wig-nesh/4-bit-cla-adder/report/images/nor_cmos_post_tran-eps-converted-to.pdf

tran1: 2023102019

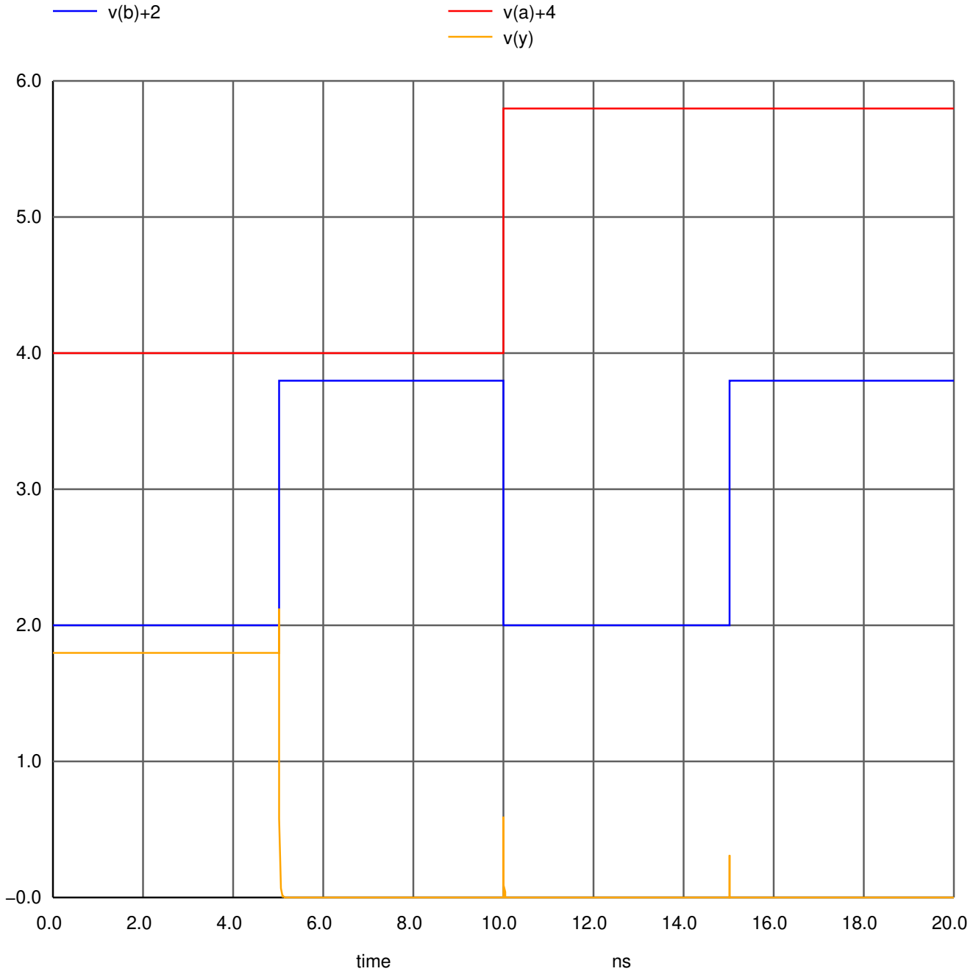
[picture p34: figure]
time
