wig-nesh/4-bit-cla-adder/report/images/xor_cmos_tran-eps-converted-to.pdf

tran1: 2023102019
v(b)+2 | v(a)+4
| v(y)

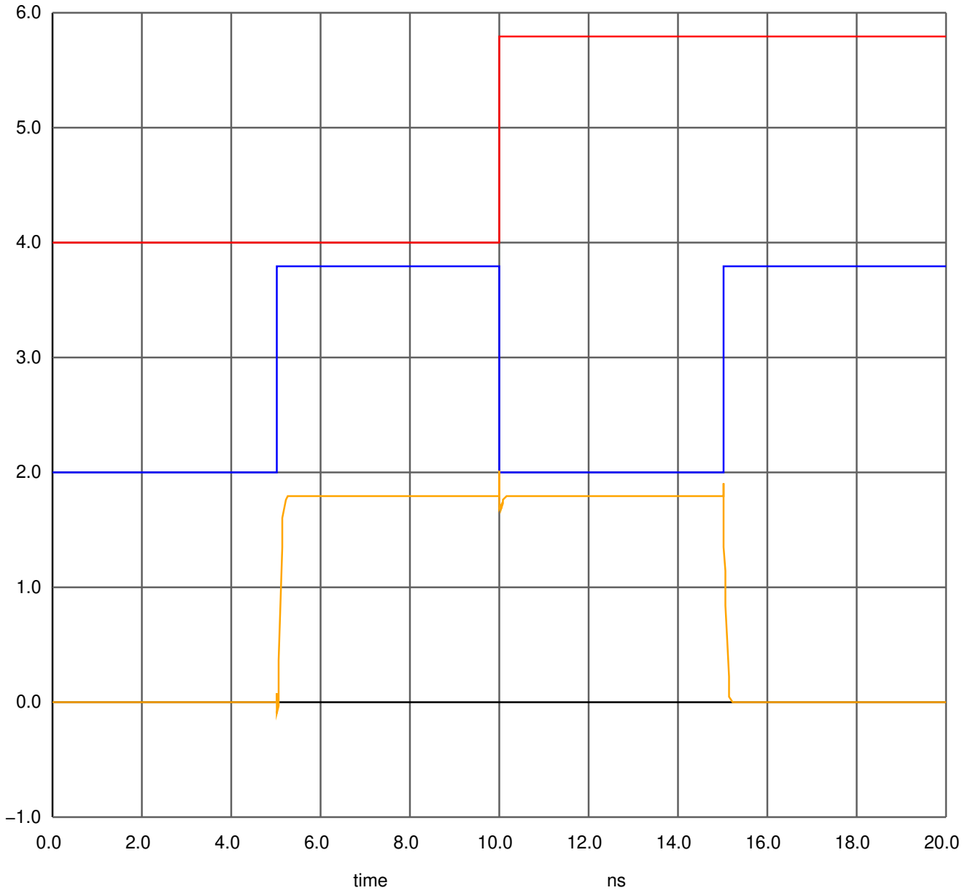
[picture p37: figure]
time
