wig-nesh/4-bit-cla-adder/verilog_fpga_simulation/full/output.pdf

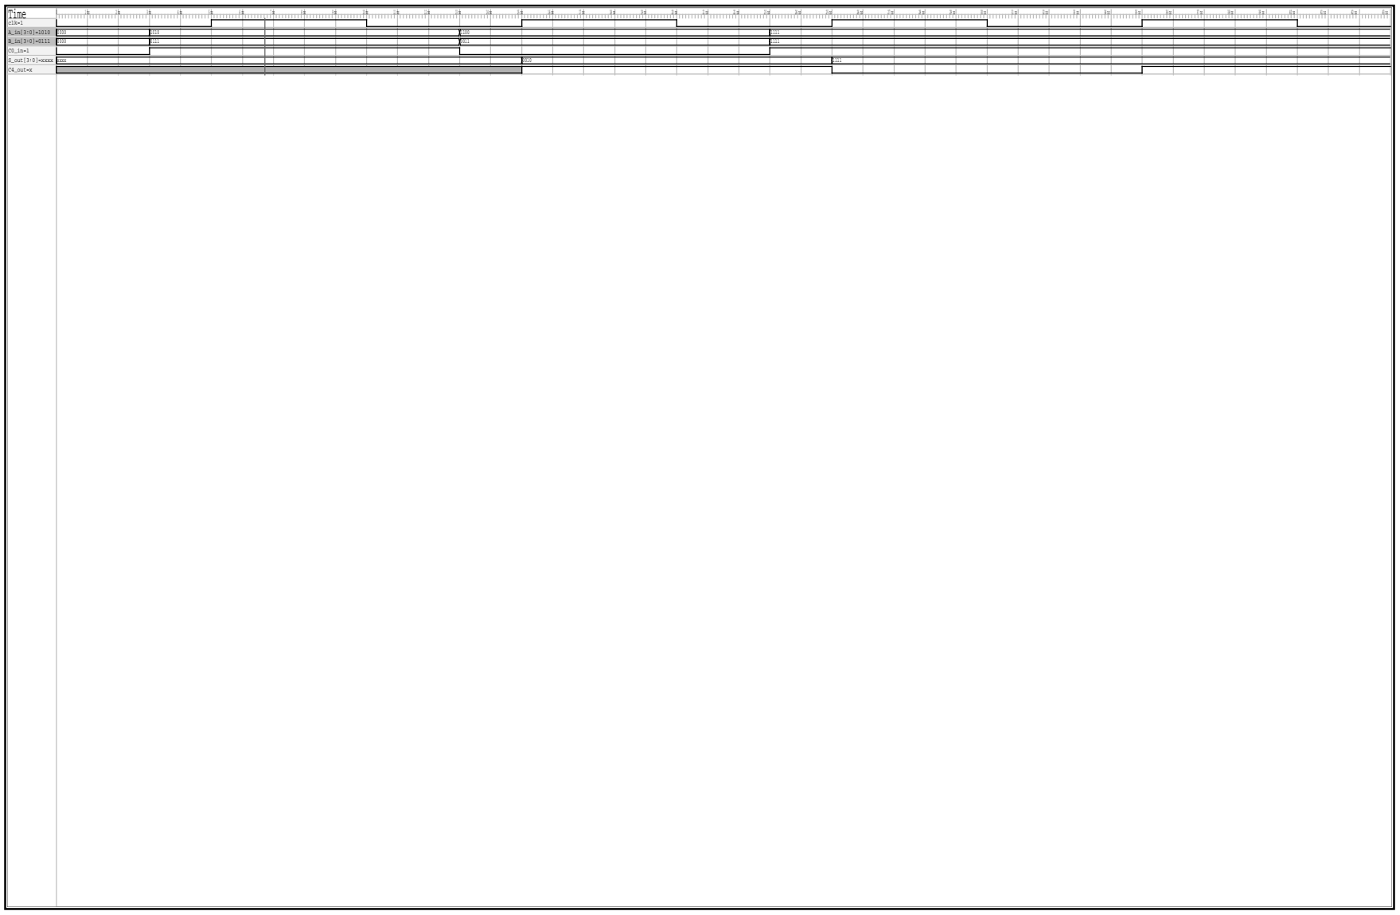
[picture p39: figure]
xxxx; Time; clk=1 A_in[3:0]=1010 B_in[3:0]=0111 C0_in=1 S_out[3:0]=xxxx C4_out=x
