wig-nesh/4-bit-cla-adder/verilog_fpga_simulation/blocks/4_bit_cla/output.pdf

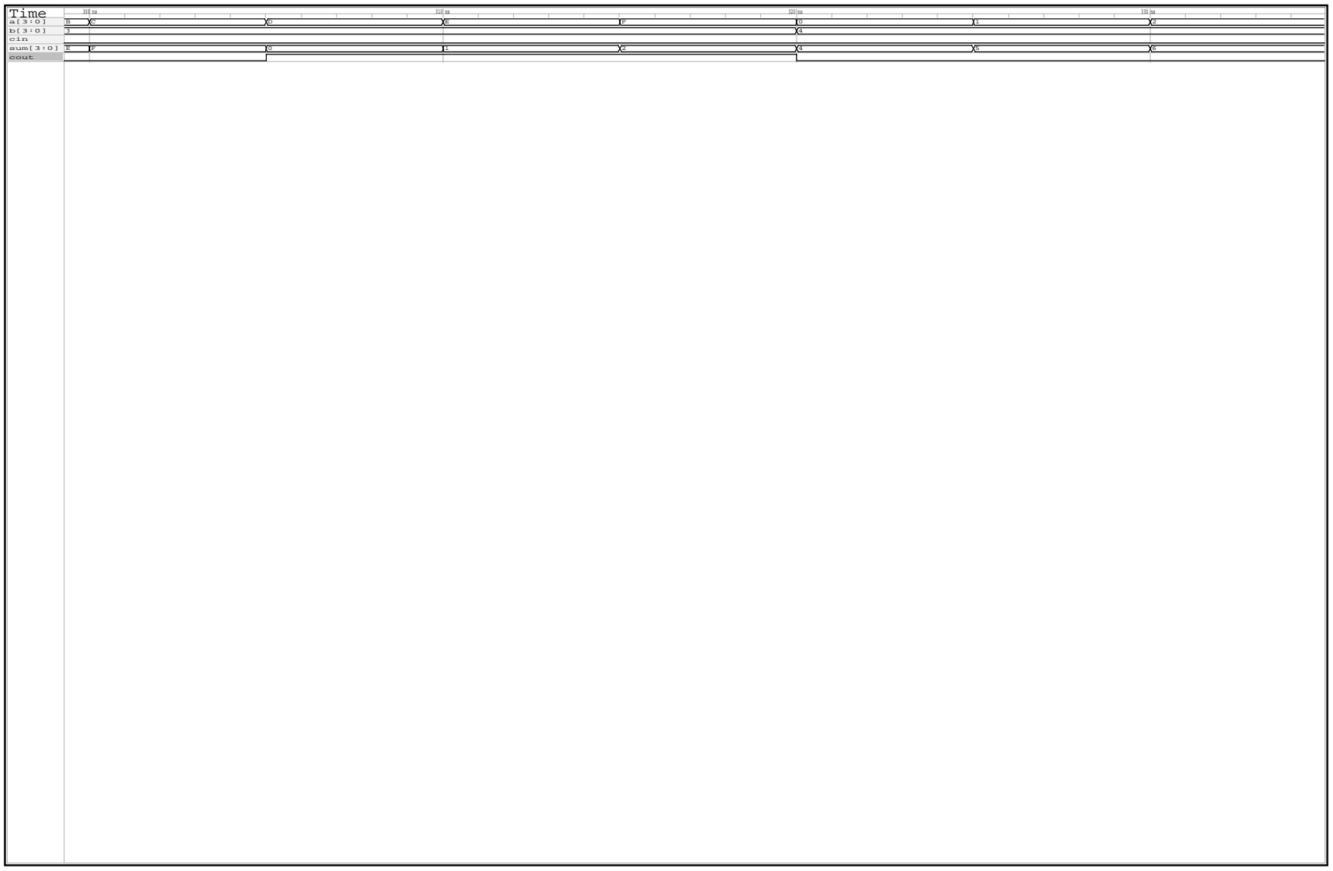
[picture p40: figure]
Time; a[3:0] b[3:0] cin sum[3:0] cout
