wig-nesh/4-bit-cla-adder/report/report.pdf

# 4-bit CLA Adder VLSI Course Project

1

# st Vignesh Vembar

# ECE, IIIT Hyderabad

2023102019

# vigneshvembar.m@students.iiit.ac.in

# Abstract—This document is a report on the Design and

Simulation of a 4-bit Carry Look Ahead Adder.

# I. INTRODUCTION

# The Carry Look Ahead Adder is a digital circuit that is used to add two 4 bit binary numbers. It is faster than the Ripple Carry Adder as it generates the carry signals for all the bits

at the same time.

# II. PROPOSED DESIGN

# A. CLA Adder

# B. D Flip Flop

# III. VERILOG SIMULATION

# A. CLA Adder

# Fig. 1: GTKWave Plot of CLA Adder Verilog Simulation

# B. D Flip Flop

# Fig. 2: GTKWave Plot of D Flip Flop Verilog Simulation

# C. Full Circuit

# IV. NGSPICE SIMULATION

# A. Inverter

time

tran1: 2023102019

0.0 | 2.0 | 4.0 | 6.0 | 8.0 | 10.0 | 12.0 | 14.0 | 16.0 | 18.0 | 20.0

ns

−0.5

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
v(y) | v(a)+2

# Fig. 3: NGSPICE Plot of Inverter

# B. NAND Gate D. XOR Gate

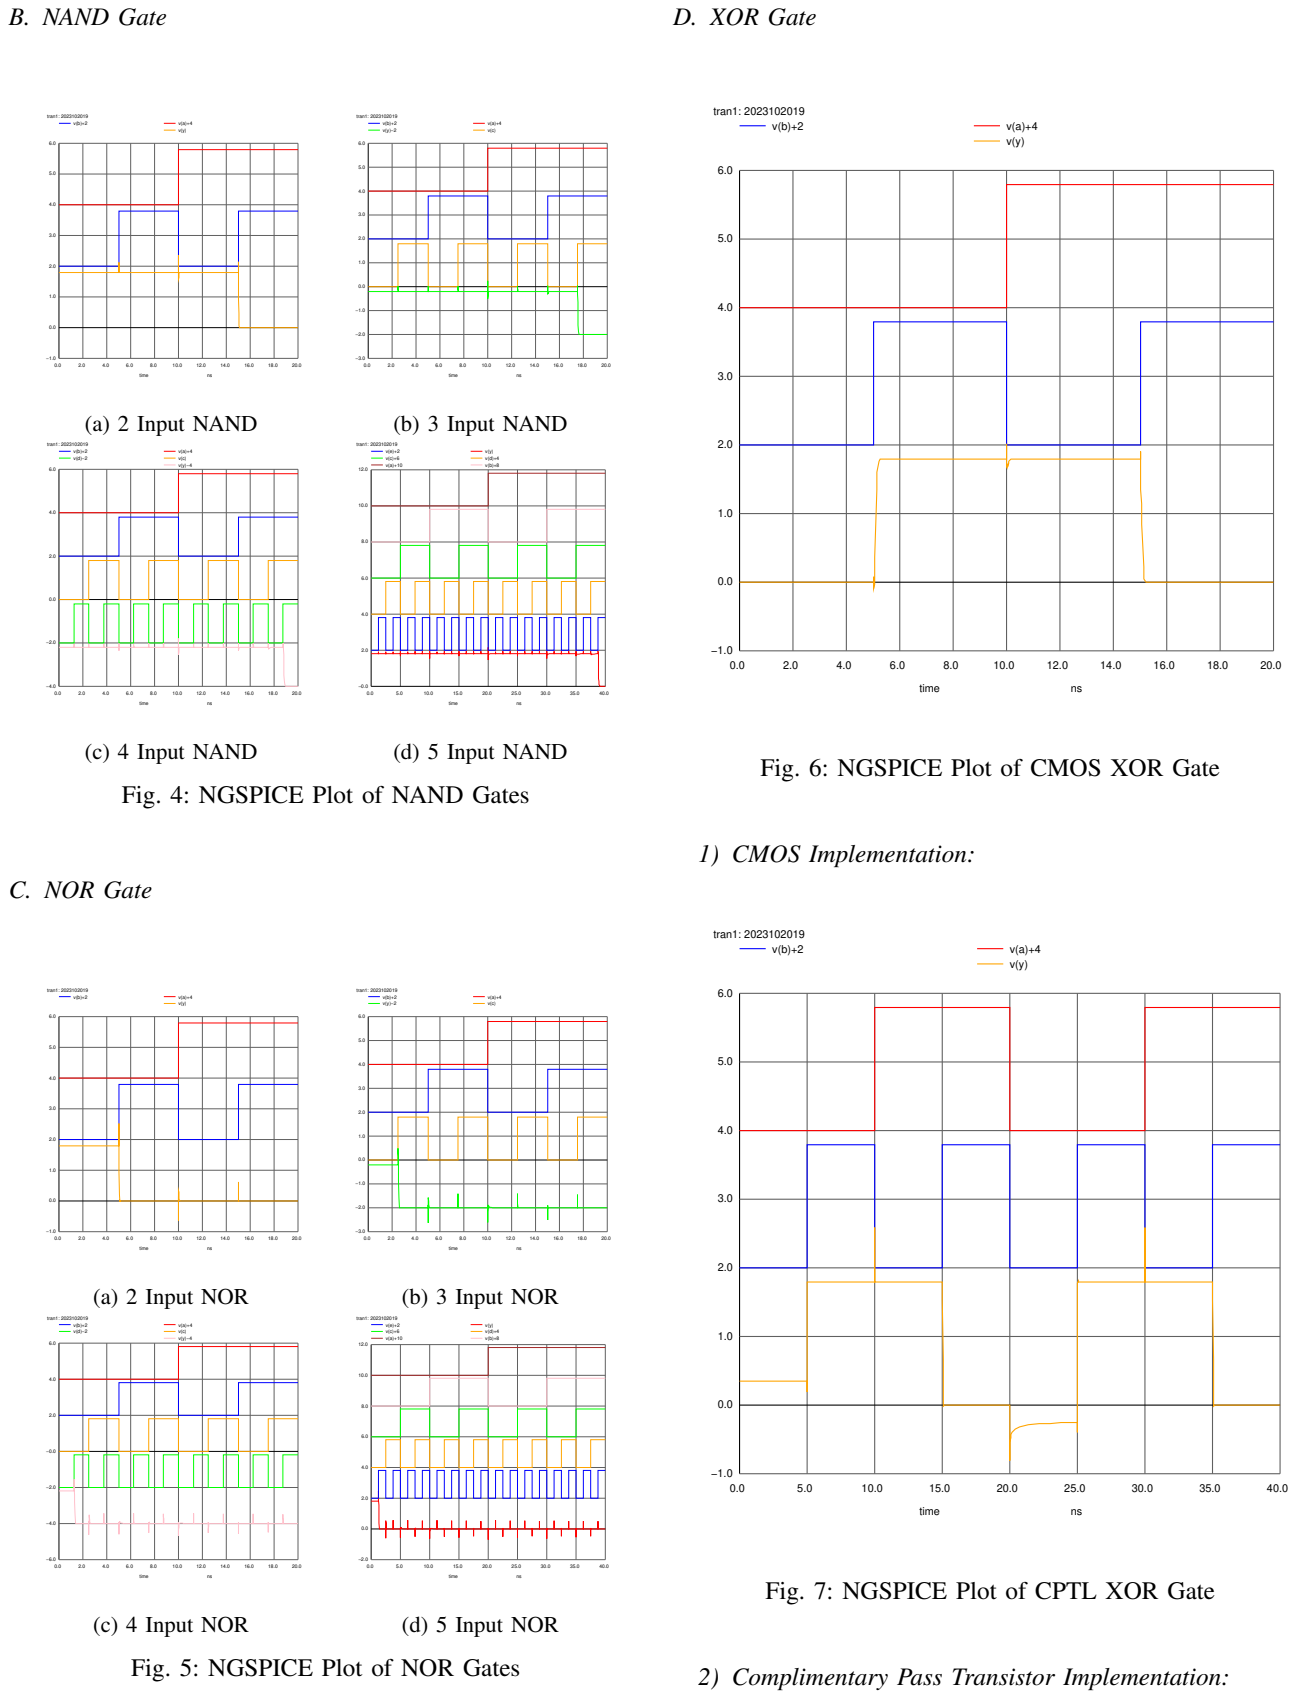
[picture p41: page 2]
time; tran1: 2023102019; (a) 2 Input NAND; (b) 3 Input NAND; (d) 5 Input NAND; C. NOR Gate; (a) 2 Input NOR; (b) 3 Input NOR; (d) 5 Input NOR; 1) CMOS Implementation:

(c) 4 Input NAND
Fig. 4: NGSPICE Plot of NAND Gates

Fig. 6: NGSPICE Plot of CMOS XOR Gate

Fig. 7: NGSPICE Plot of CPTL XOR Gate

(c) 4 Input NOR
Fig. 5: NGSPICE Plot of NOR Gates

2) Complimentary Pass Transistor Implementation:

# E. Propagate/Generate Generator

# F. Carry Look Ahead Generator

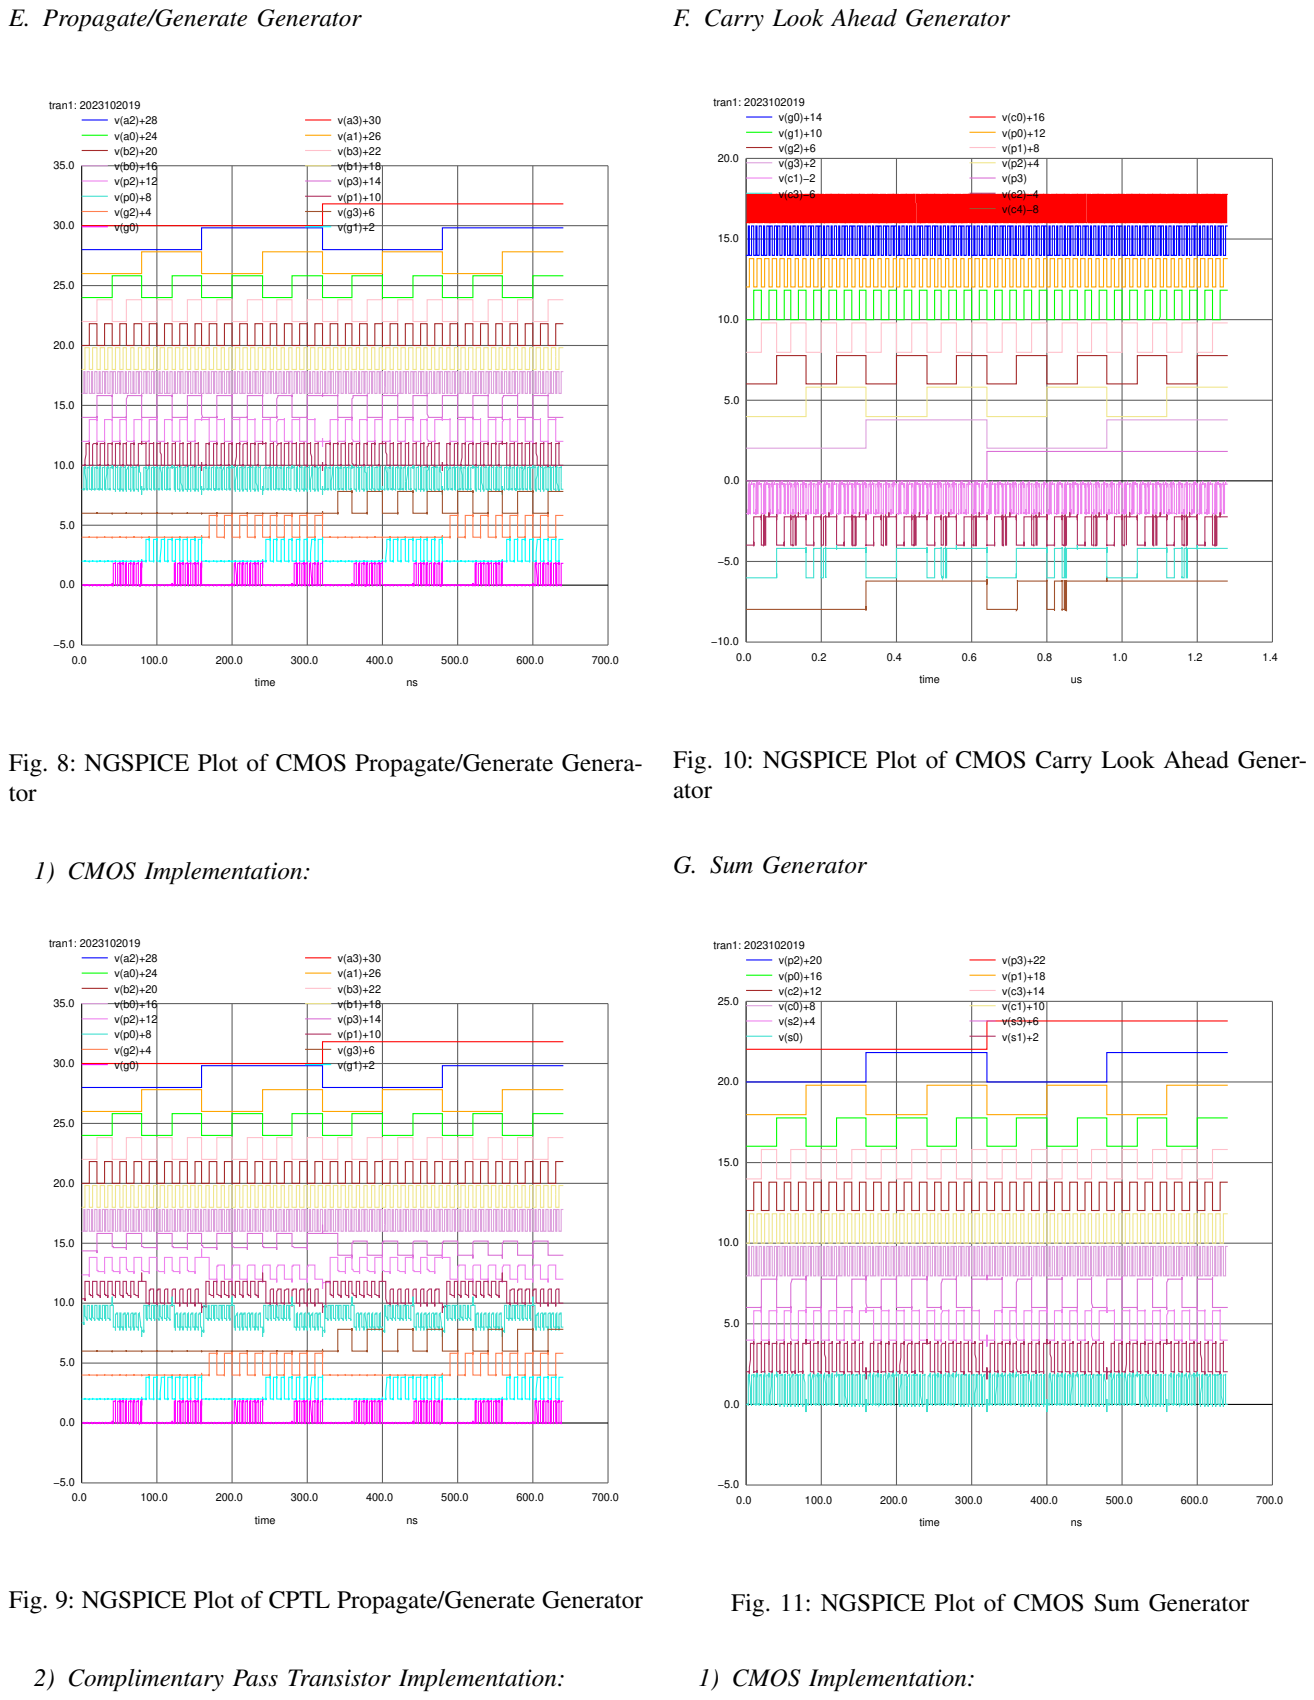
[picture p42: page 3]
time; tran1: 2023102019; 1) CMOS Implementation:; G. Sum Generator

Fig. 8: NGSPICE Plot of CMOS Propagate/Generate Genera-
tor

Fig. 10: NGSPICE Plot of CMOS Carry Look Ahead Gener-
ator

Fig. 9: NGSPICE Plot of CPTL Propagate/Generate Generator

Fig. 11: NGSPICE Plot of CMOS Sum Generator

2) Complimentary Pass Transistor Implementation:

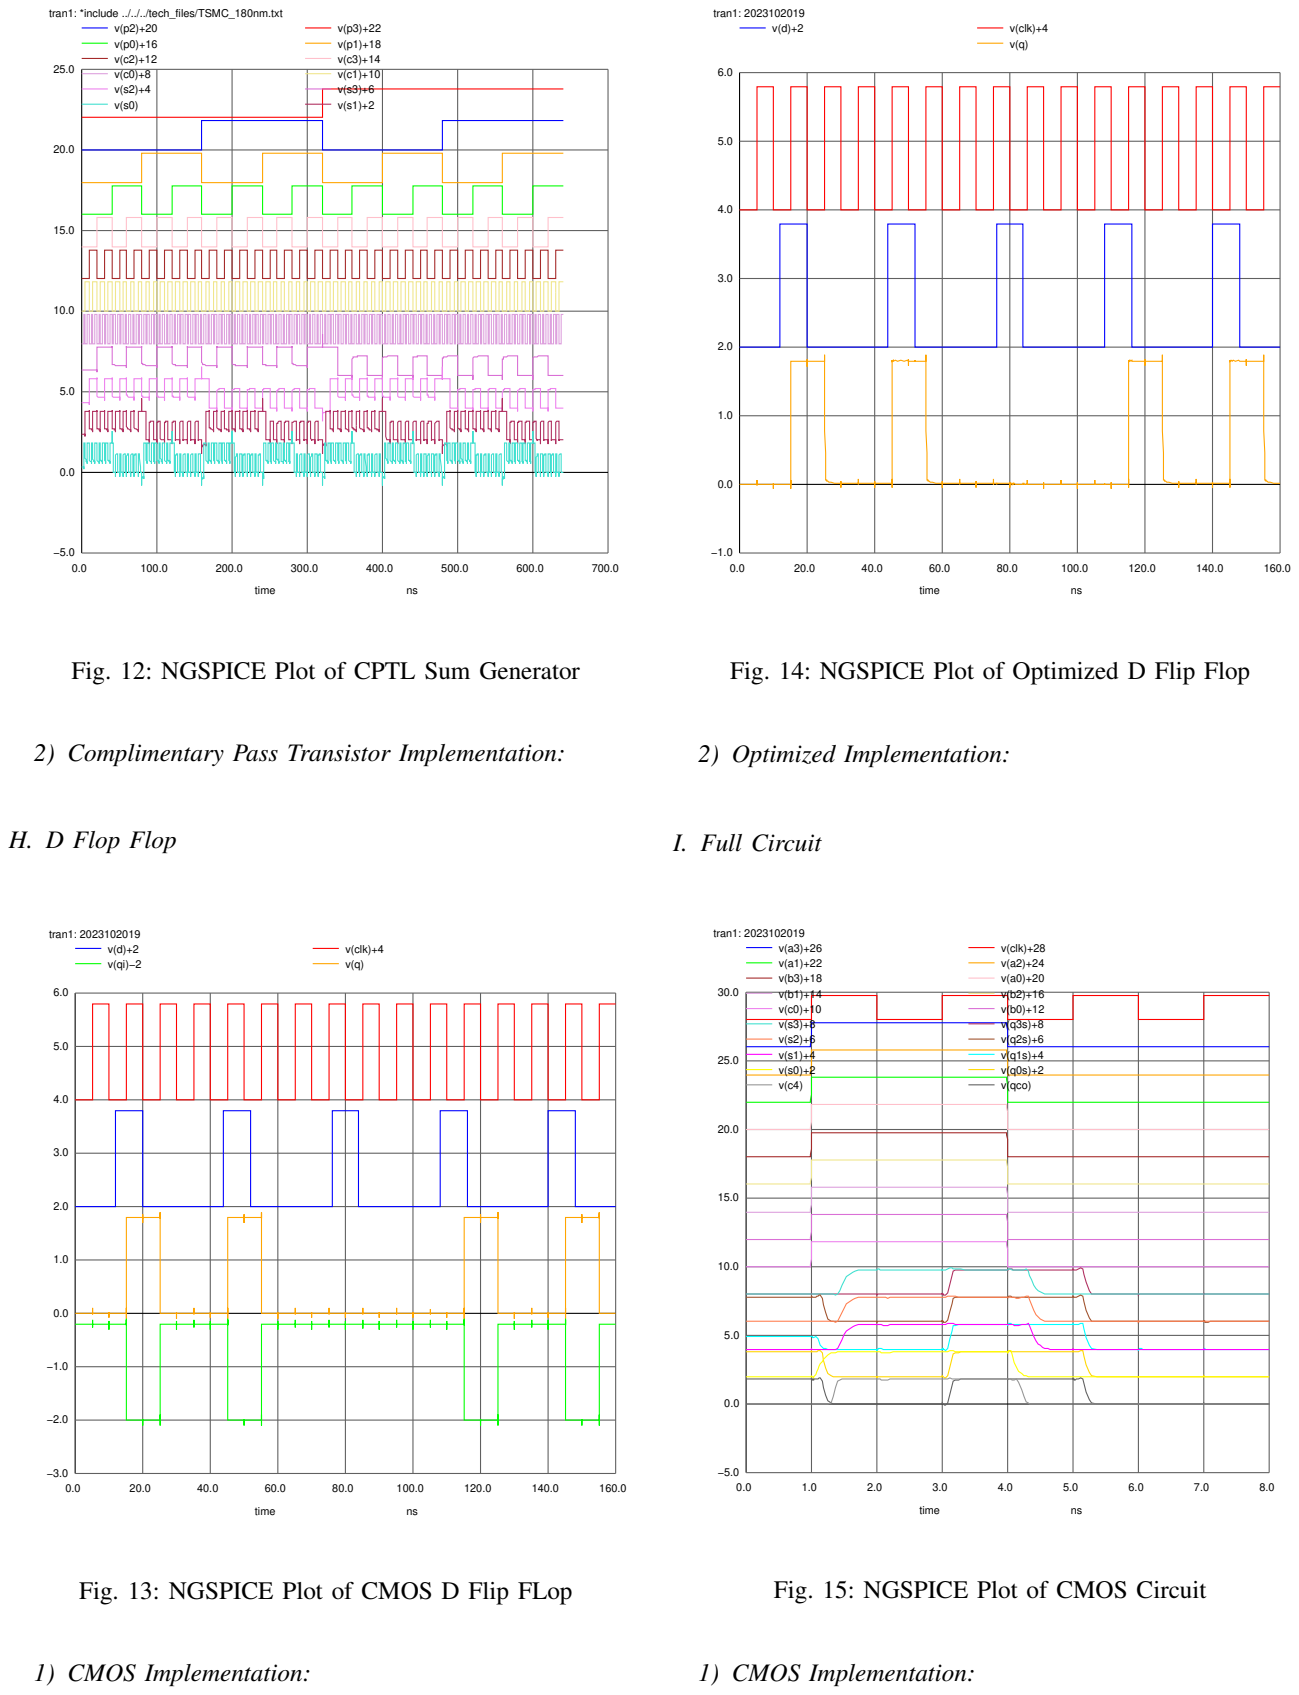
[picture p43: page 4]
time; tran1: *include ../../../tech_files/TSMC_180nm.txt; H. D Flop Flop; tran1: 2023102019; v(clk)+4; 1) CMOS Implementation:; 2) Optimized Implementation:; I. Full Circuit; v(clk)+28; v(qco)

Fig. 12: NGSPICE Plot of CPTL Sum Generator

Fig. 14: NGSPICE Plot of Optimized D Flip Flop

2) Complimentary Pass Transistor Implementation:

Fig. 13: NGSPICE Plot of CMOS D Flip FLop

Fig. 15: NGSPICE Plot of CMOS Circuit

# B. NAND Gate

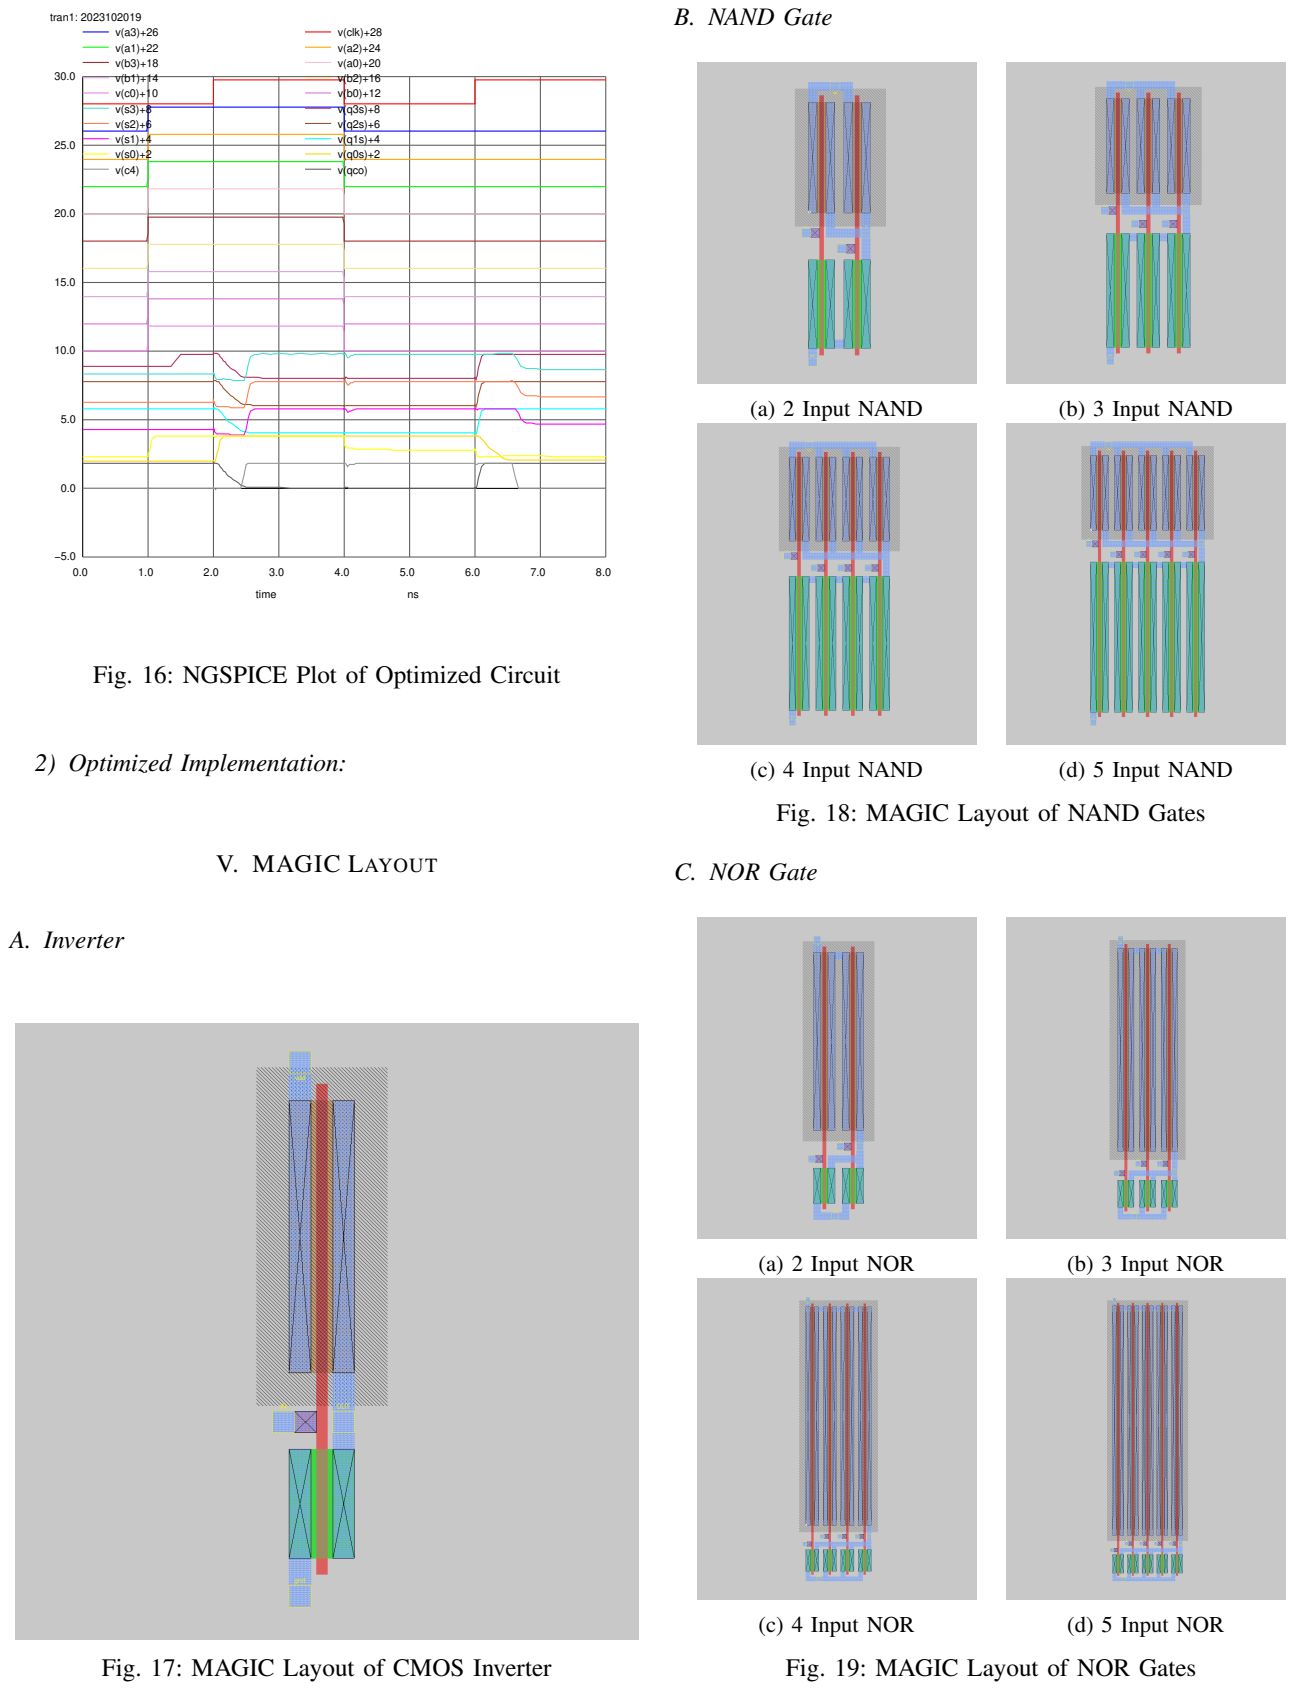
[picture p44: page 5]
time; tran1: 2023102019; v(clk)+28; 2) Optimized Implementation:; V. MAGIC LAYOUT; A. Inverter; (a) 2 Input NAND; (b) 3 Input NAND; (c) 4 Input NAND; (d) 5 Input NAND; C. NOR Gate; (a) 2 Input NOR; (b) 3 Input NOR; (c) 4 Input NOR; (d) 5 Input NOR

v(s0)+2 v(c4) | v(q0s)+2 v(qco)

Fig. 16: NGSPICE Plot of Optimized Circuit

Fig. 18: MAGIC Layout of NAND Gates

Fig. 19: MAGIC Layout of NOR Gates

Fig. 17: MAGIC Layout of CMOS Inverter

# D. XOR Gate

# E. Propagate/Generate Generator

# F. Carry Look Ahead Generator

# G. Sum Generator

# H. D Flop Flop

# I. Full Circuit

# VI. POST LAYOUT SIMULATION

# A. Inverter

# B. NAND Gate

# C. NOR Gate

# D. XOR Gate

# E. Propagate/Generate Generator

# F. Carry Look Ahead Generator

# G. Sum Generator

# H. D Flop Flop

# I. Full Circuit

# VII. FPGA SIMULATION

# ACKNOWLEDGMENT

# REFERENCES

[1]
