wig-nesh/4-bit-cla-adder/report/images/full_optimized_tran-eps-converted-to.pdf

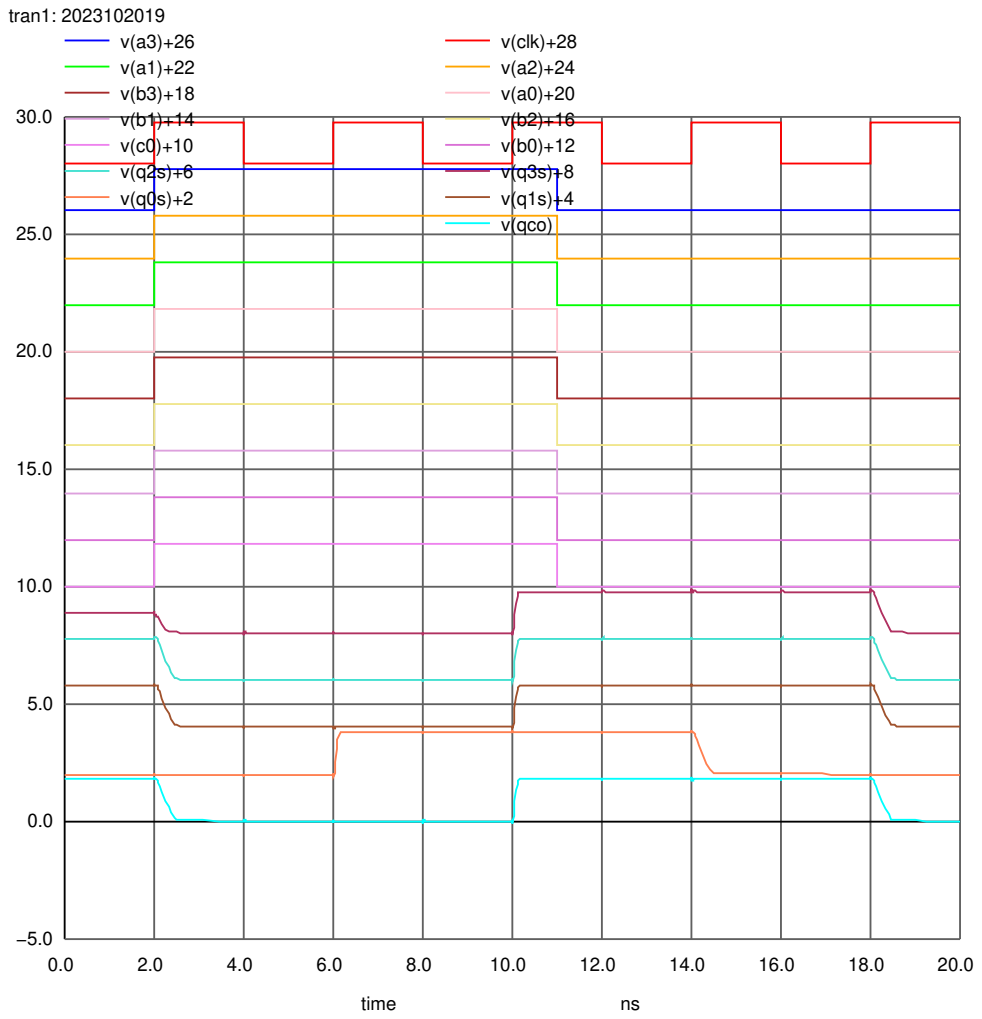
[picture p46: page 1]
time; tran1: 2023102019; v(clk)+28; v(qco)
