wig-nesh/4-bit-cla-adder/report/images/d_ff_optimized_post_tran-eps-converted-to.pdf

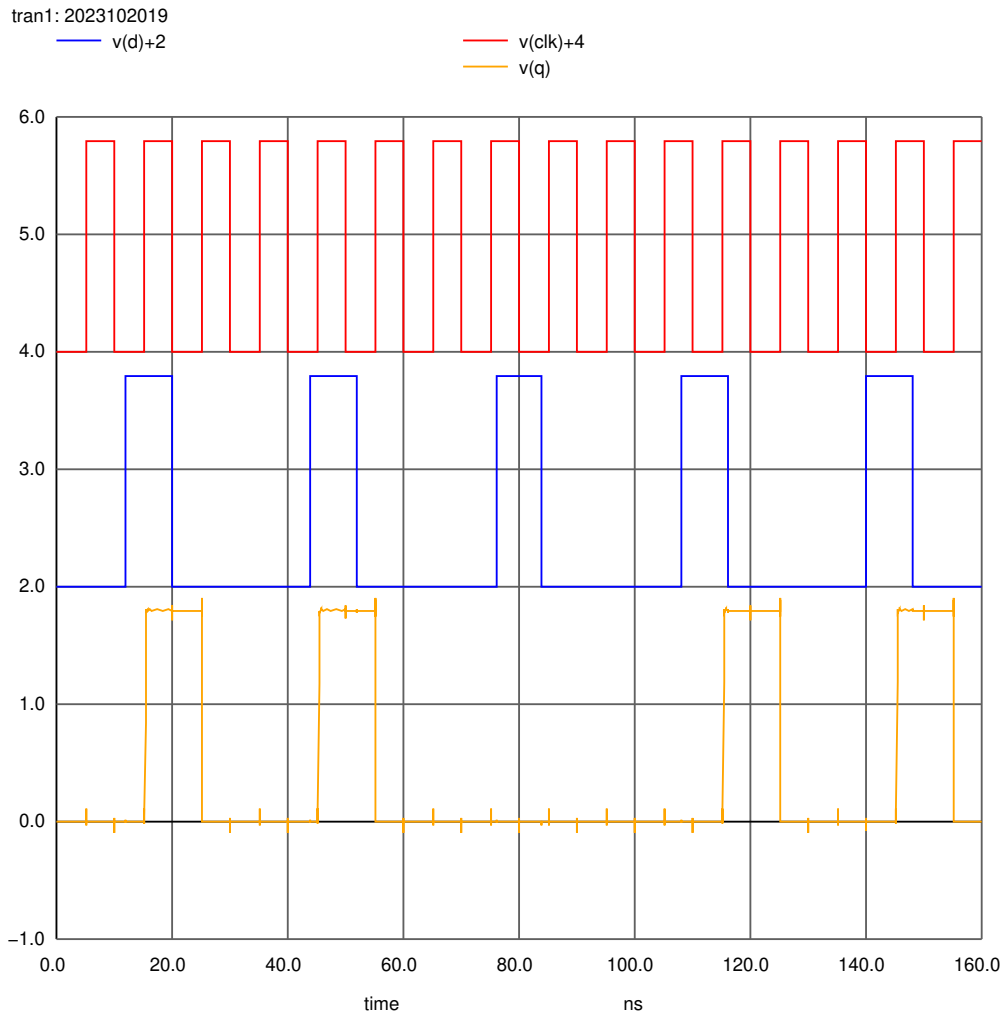
[picture p47: page 1]
time; tran1: 2023102019; v(clk)+4
