wig-nesh/4-bit-cla-adder/report/images/nand_3_cmos_post_tran-eps-converted-to.pdf

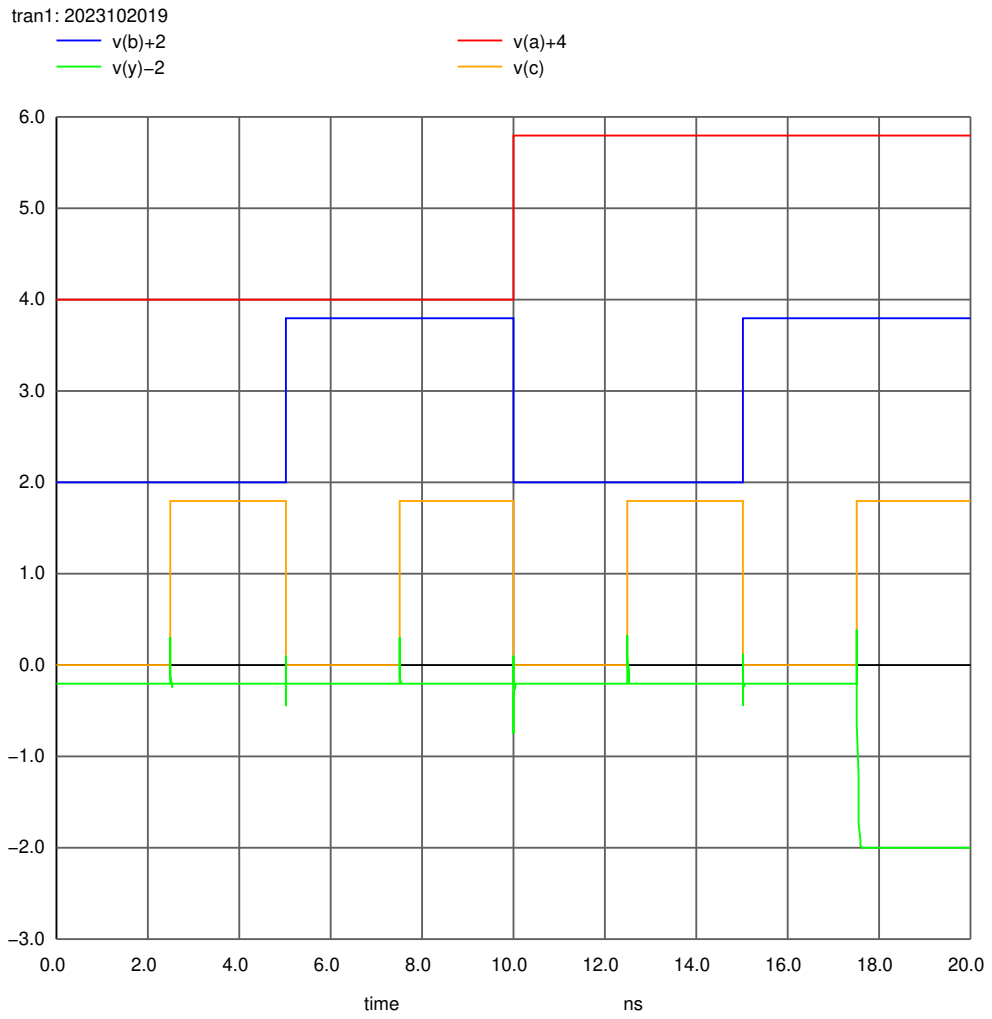
[picture p48: page 1]
time; tran1: 2023102019
