wig-nesh/4-bit-cla-adder/report/images/nor_3_cmos_post_tran-eps-converted-to.pdf

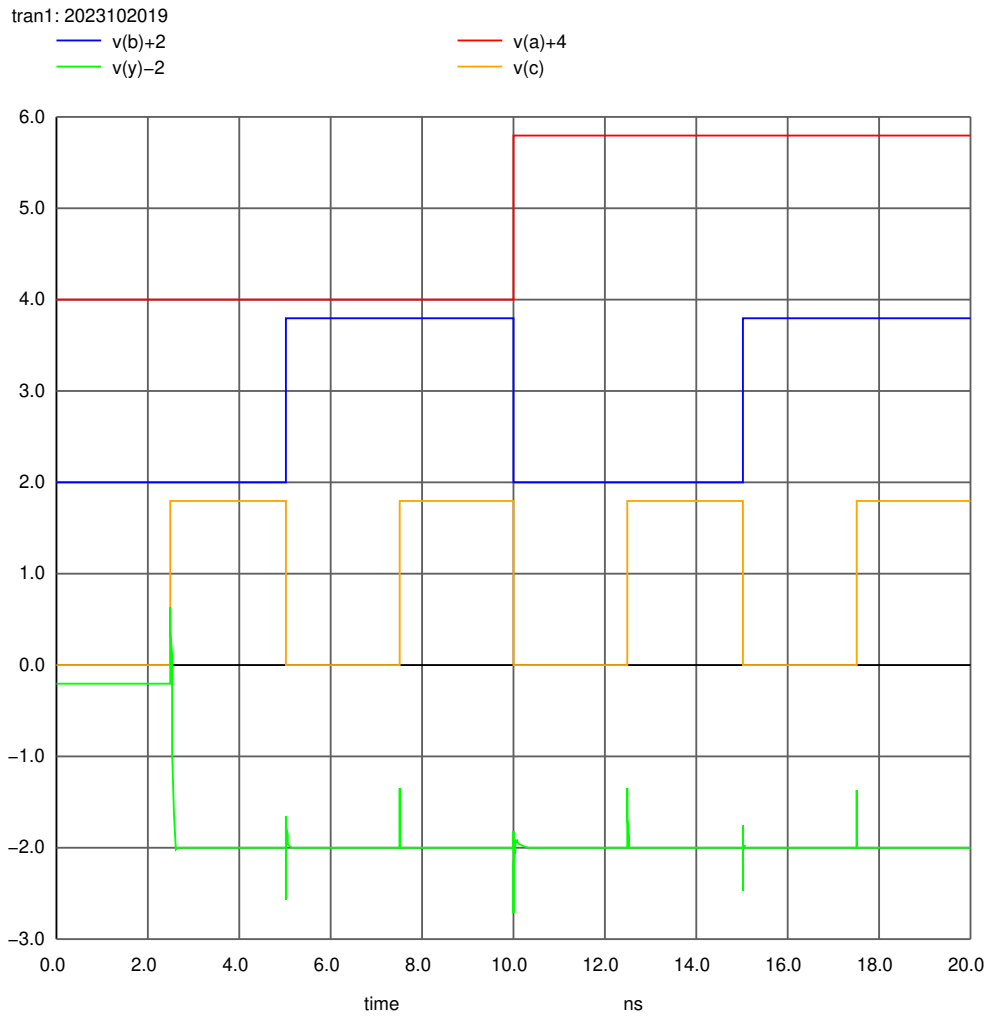
[picture p51: page 1]
time; tran1: 2023102019
