wig-nesh/4-bit-cla-adder/report/images/nor_4_cmos_post_tran-eps-converted-to.pdf

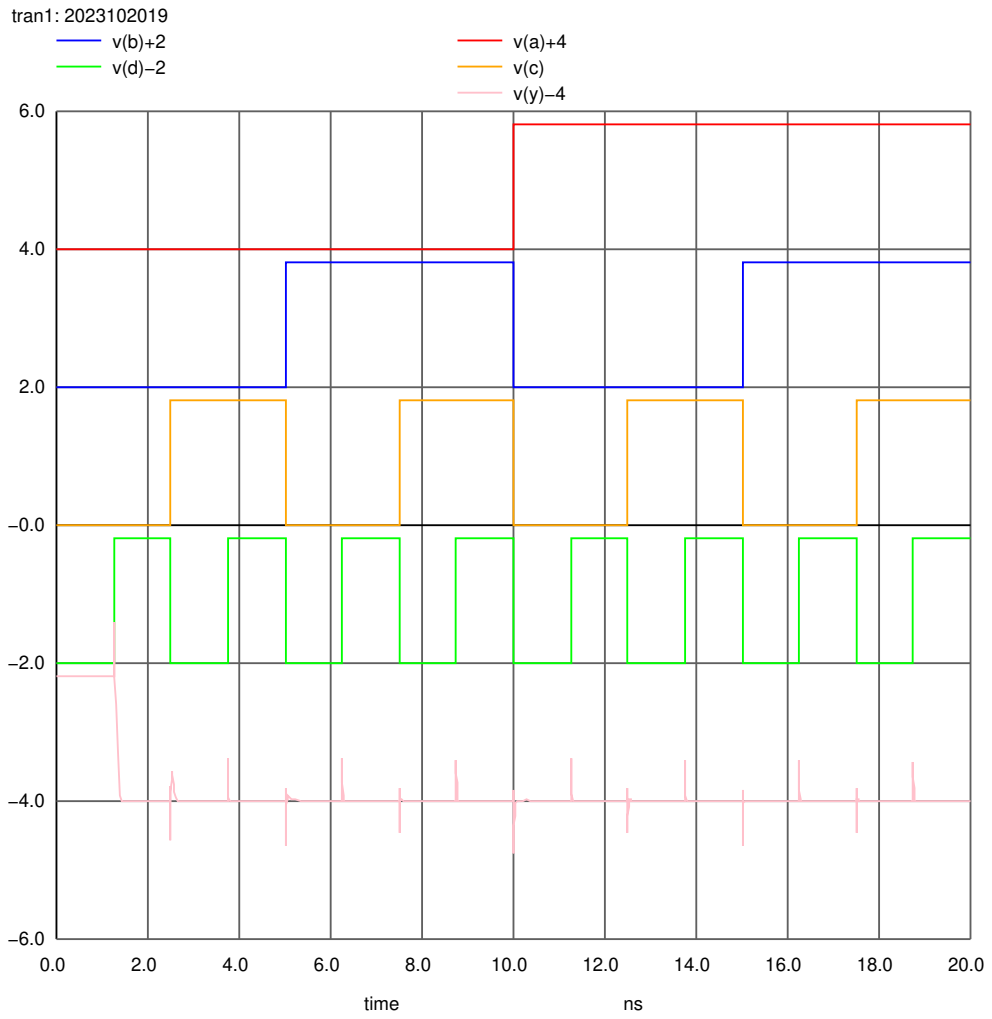
[picture p52: page 1]
time; tran1: 2023102019
