wig-nesh/4-bit-cla-adder/report/images/nor_5_cmos_post_tran-eps-converted-to.pdf

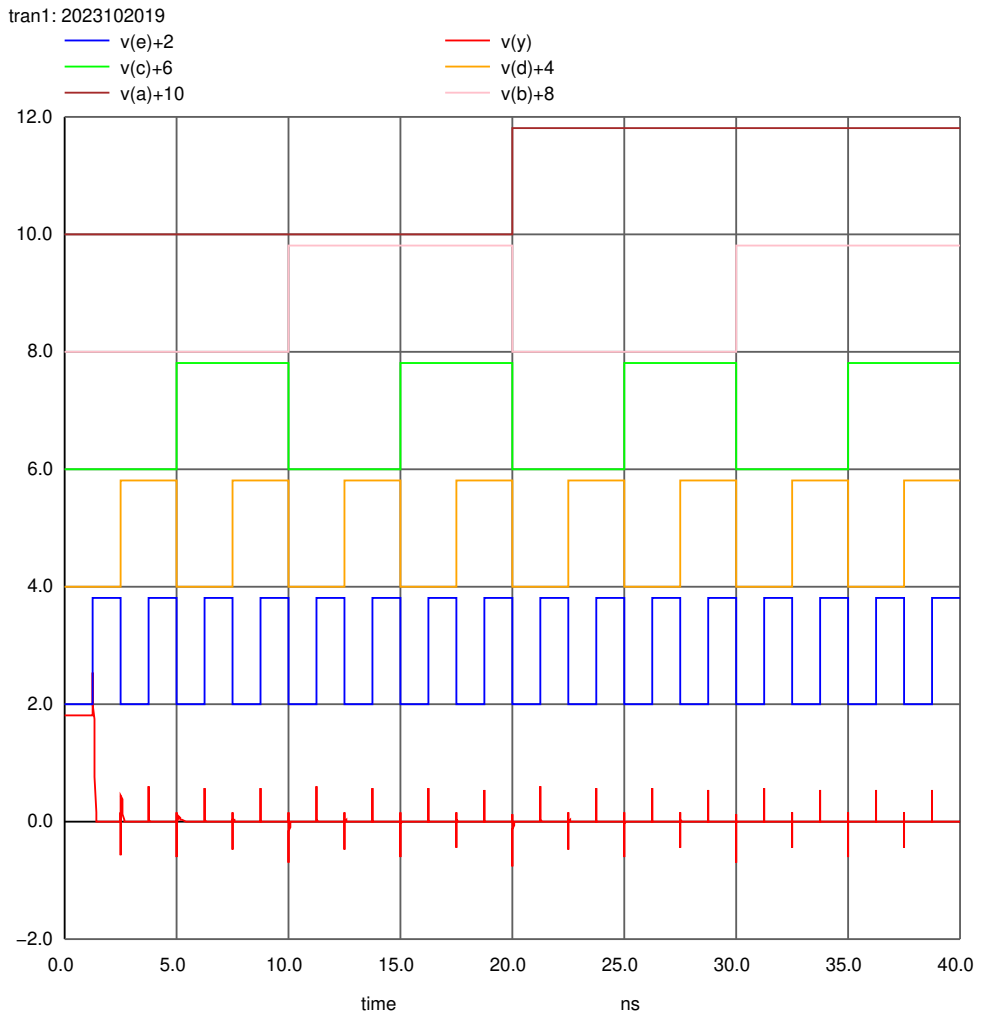
[picture p53: page 1]
time; tran1: 2023102019
