wig-nesh/4-bit-cla-adder/report/images/xor_optimized_post_tran-eps-converted-to.pdf

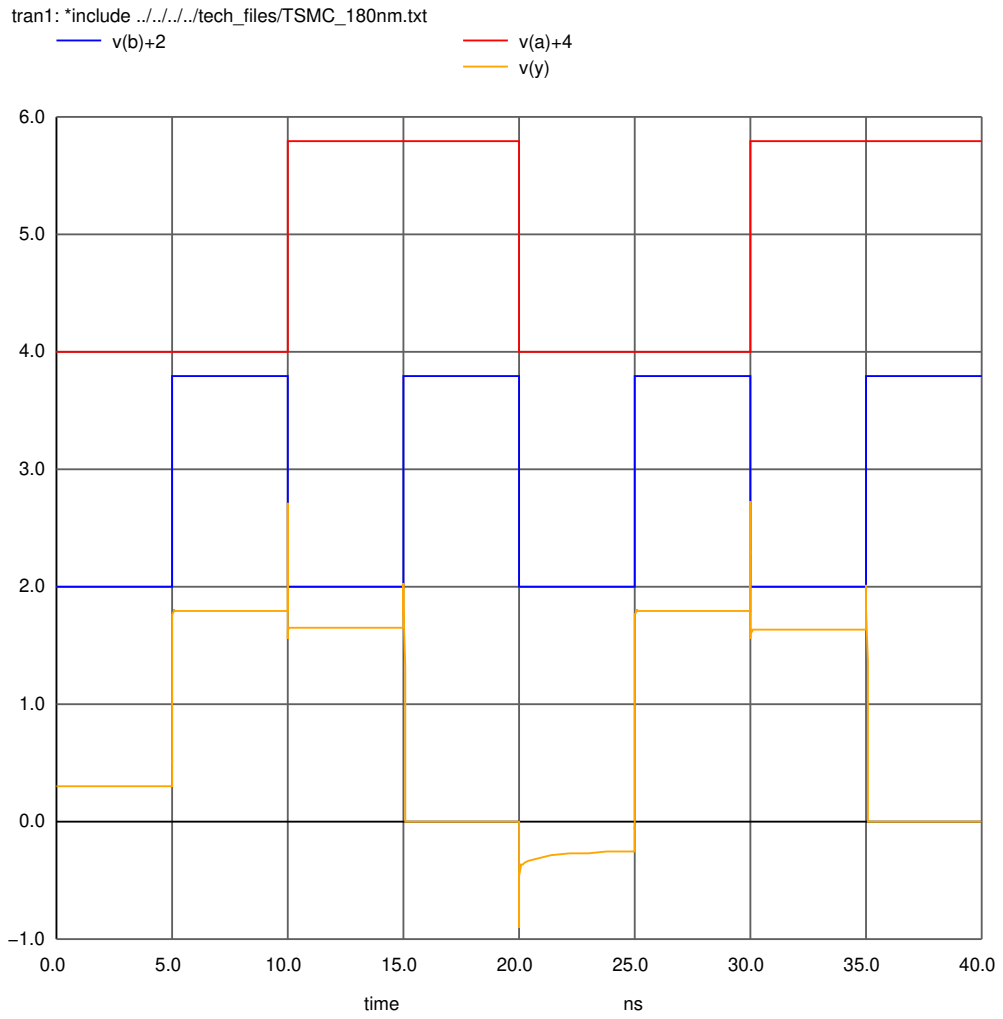
[picture p54: page 1]
time; tran1: *include ../../../../tech_files/TSMC_180nm.txt
