wig-nesh/4-bit-cla-adder/report/images/d_ff_cmos_tran-eps-converted-to.pdf

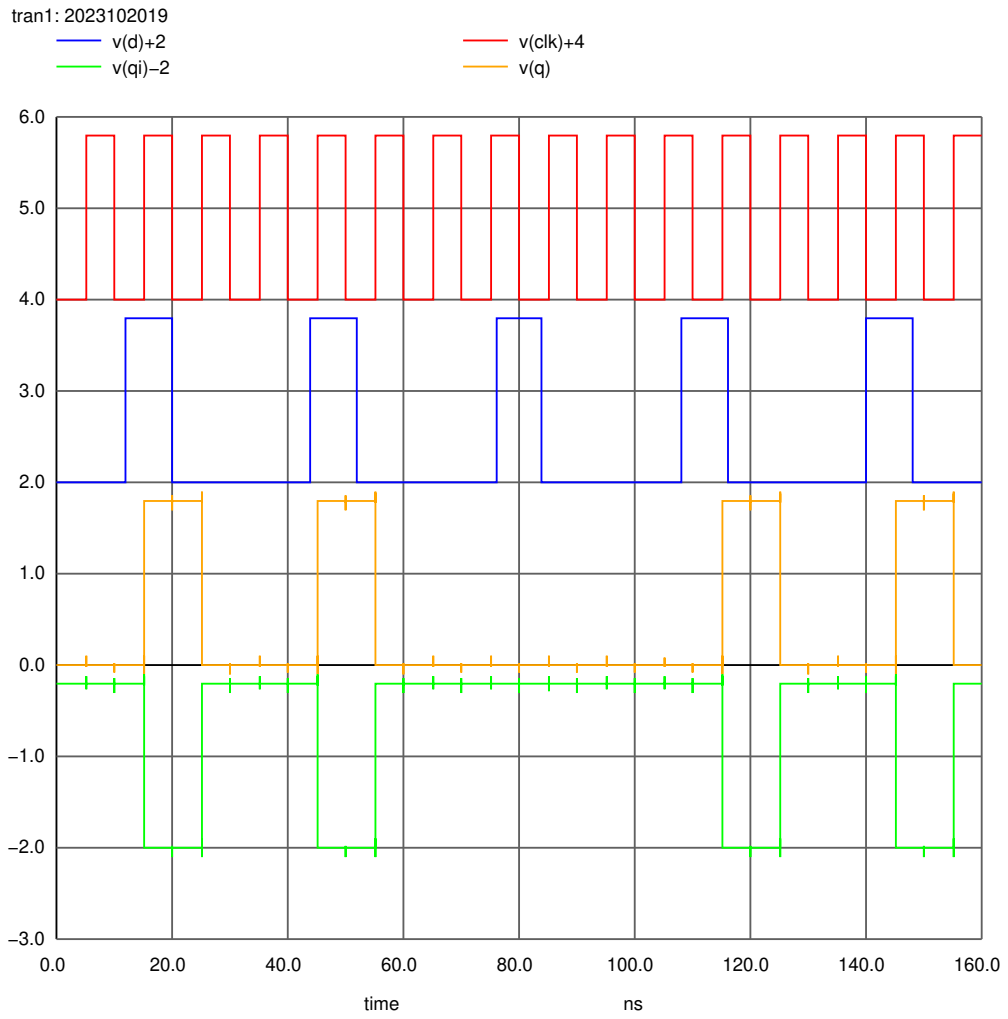
[picture p56: page 1]
time; tran1: 2023102019; v(clk)+4
