wig-nesh/4-bit-cla-adder/report/images/d_ff_optimized_tran-eps-converted-to.pdf

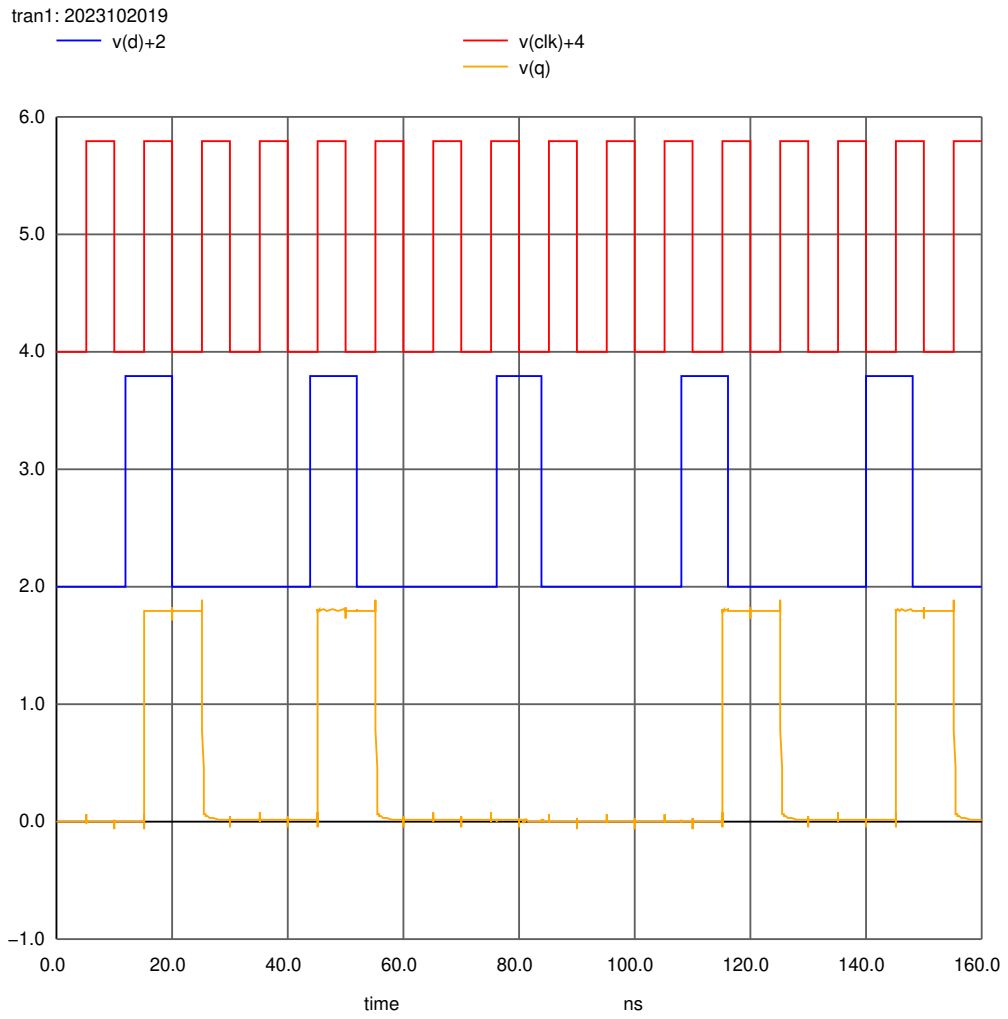
[picture p57: page 1]
time; tran1: 2023102019; v(clk)+4
