wig-nesh/4-bit-cla-adder/report/images/full_cmos_tran-eps-converted-to.pdf

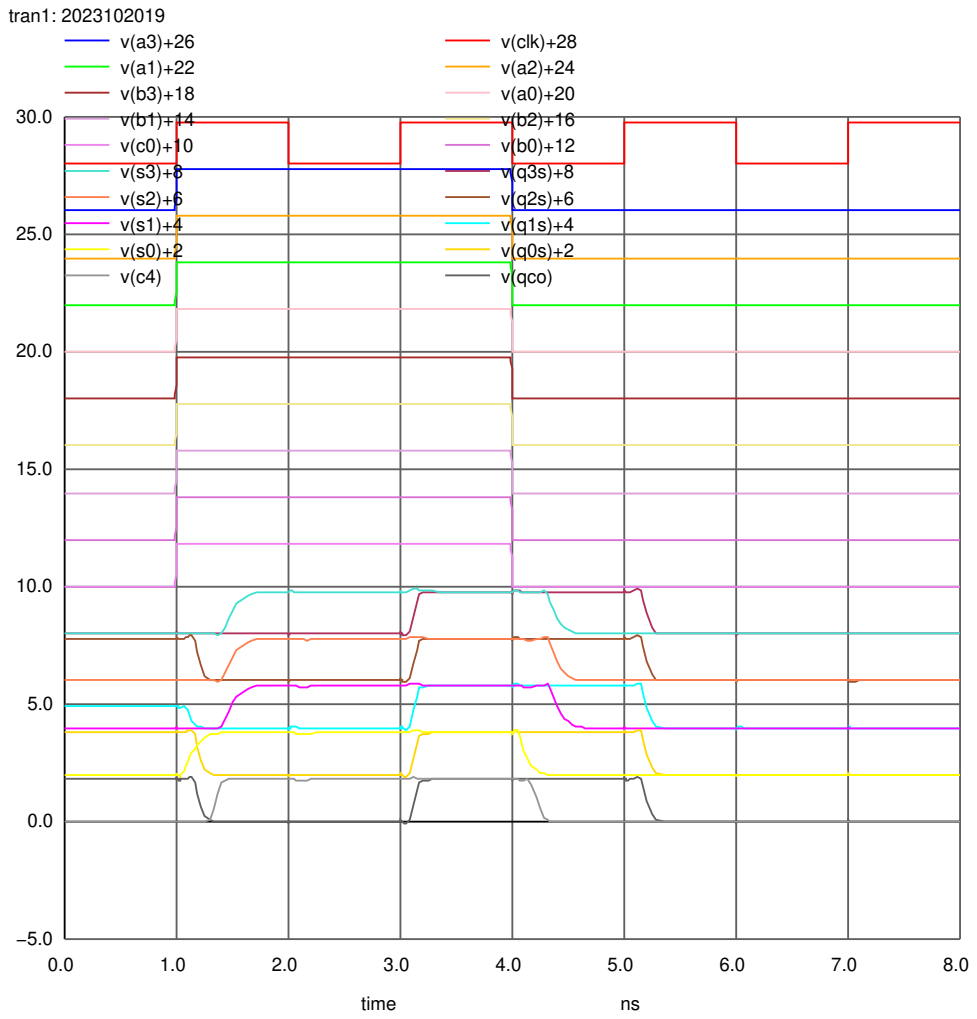
[picture p58: page 1]
time; tran1: 2023102019; v(clk)+28; v(qco)
