wig-nesh/4-bit-cla-adder/report/images/nand_3_cmos_tran-eps-converted-to.pdf

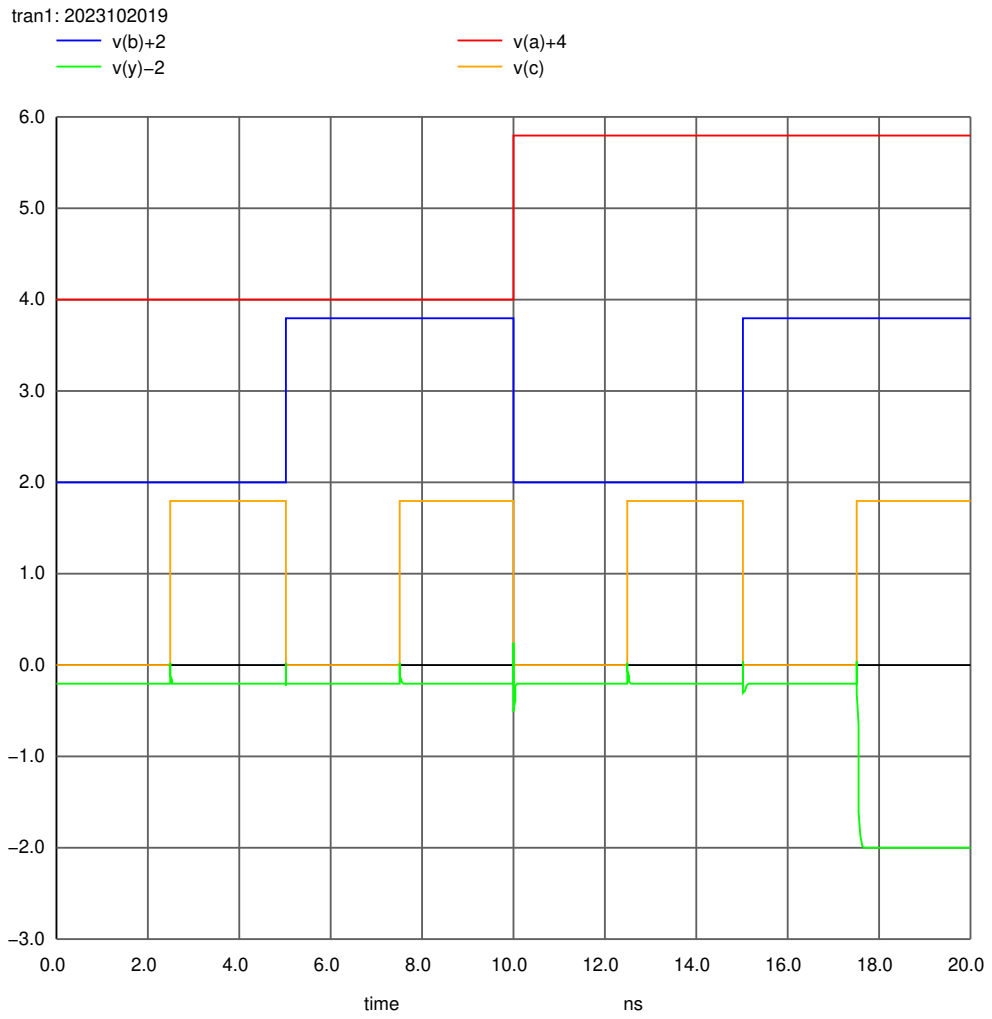
[picture p59: page 1]
time; tran1: 2023102019
