wig-nesh/4-bit-cla-adder/report/images/nand_5_cmos_tran-eps-converted-to.pdf

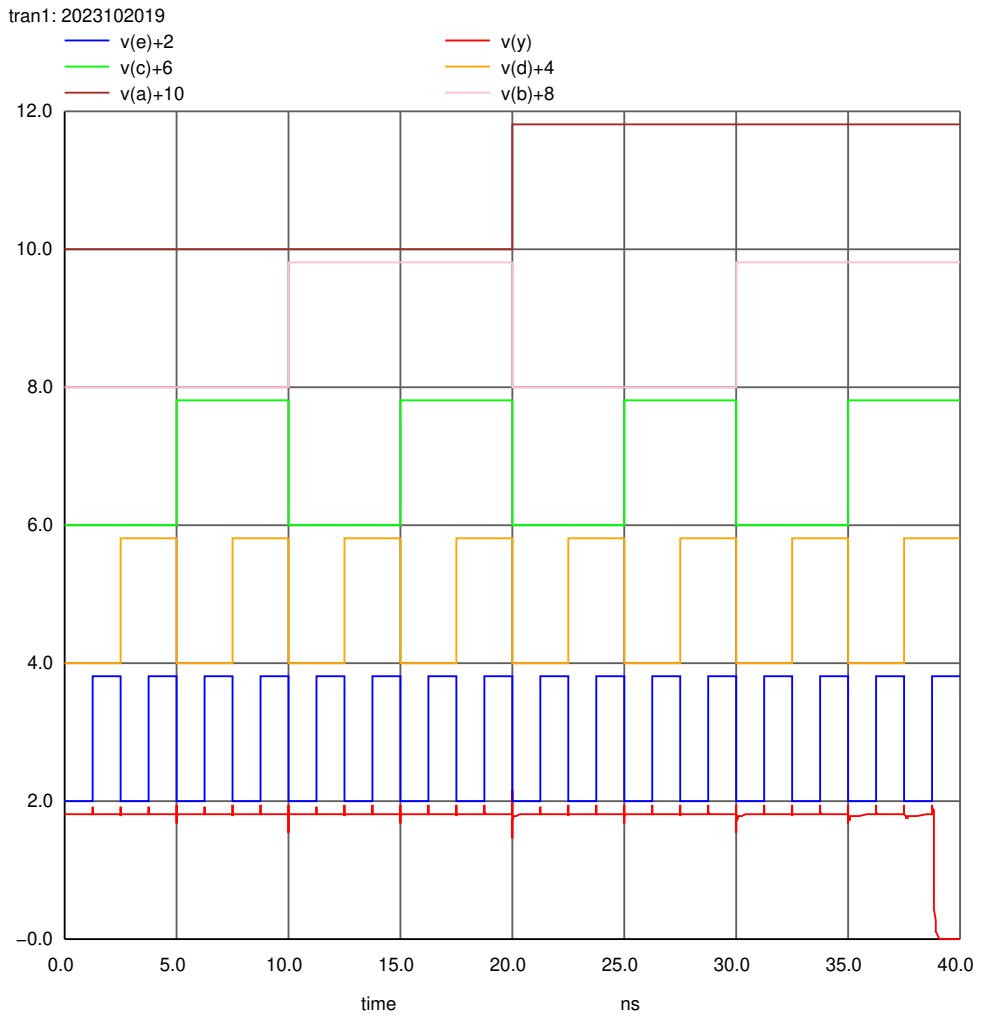
[picture p61: page 1]
time; tran1: 2023102019
