wig-nesh/4-bit-cla-adder/report/images/nor_4_cmos_tran-eps-converted-to.pdf

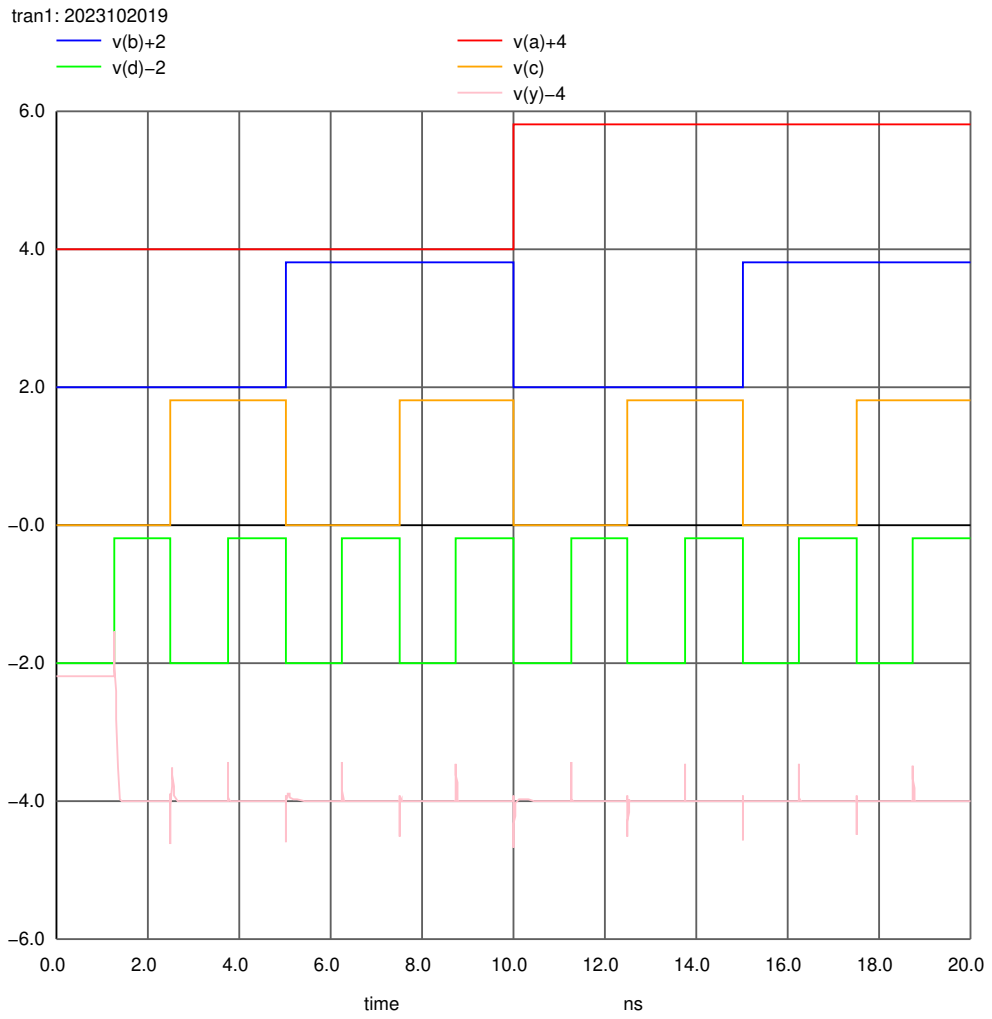
[picture p63: page 1]
time; tran1: 2023102019
