wig-nesh/4-bit-cla-adder/report/images/pg_gen_cmos_tran-eps-converted-to.pdf

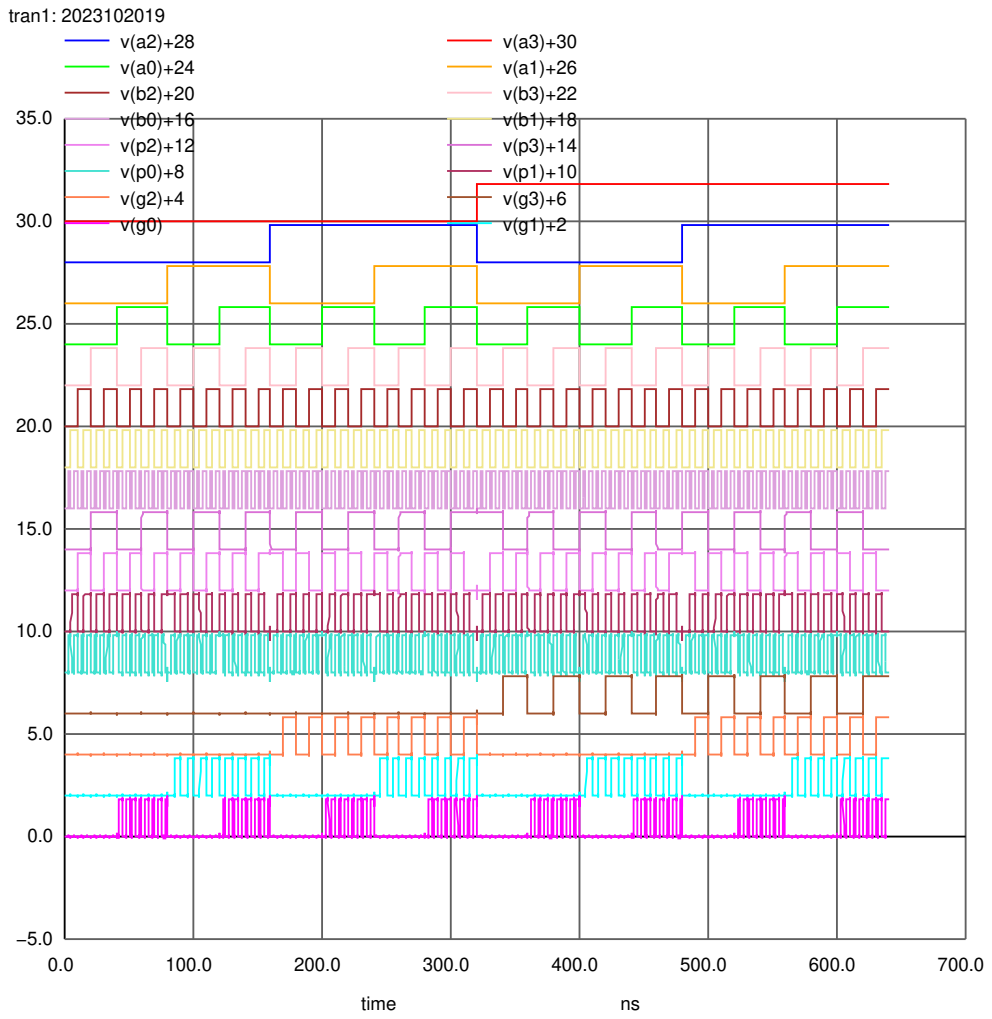
[picture p65: page 1]
time; tran1: 2023102019
