wig-nesh/4-bit-cla-adder/report/images/pg_gen_optimized_tran-eps-converted-to.pdf

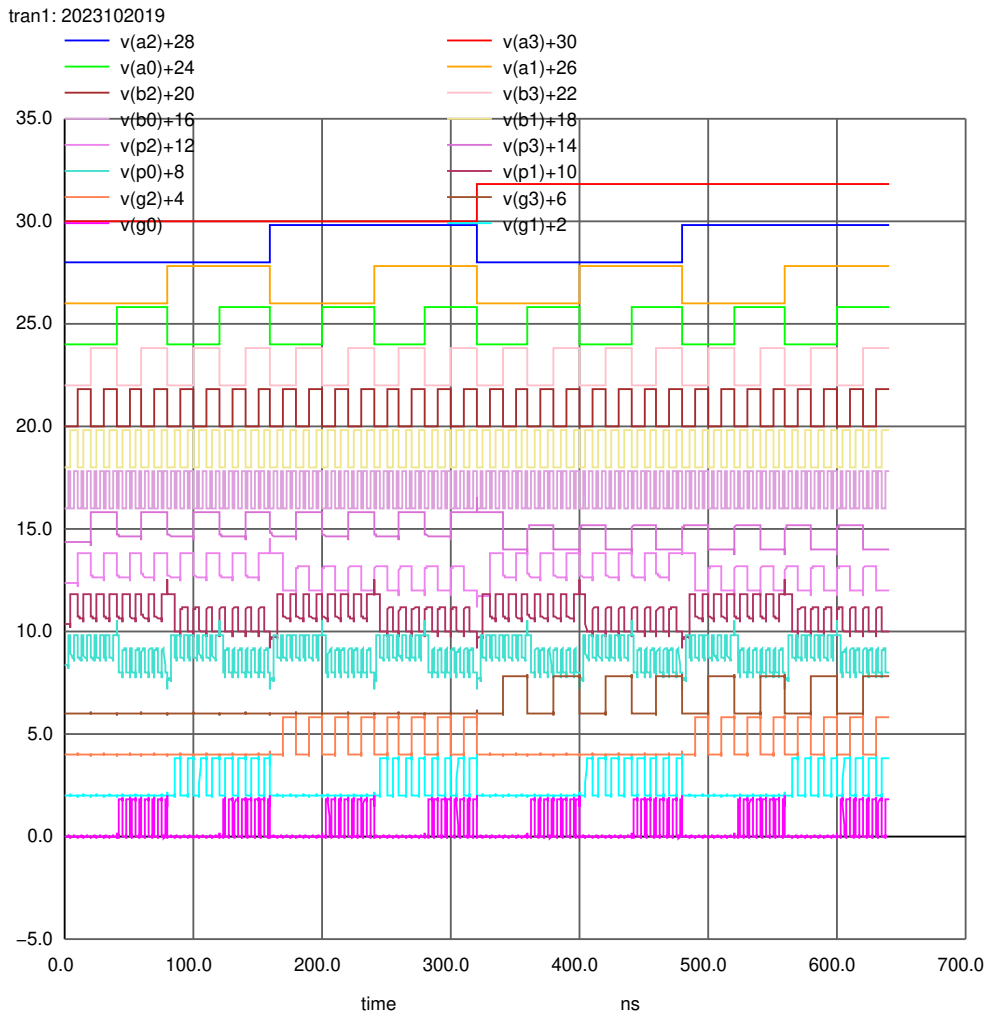
[picture p66: page 1]
time; tran1: 2023102019
