wig-nesh/4-bit-cla-adder/report/images/sum_gen_cmos_tran-eps-converted-to.pdf

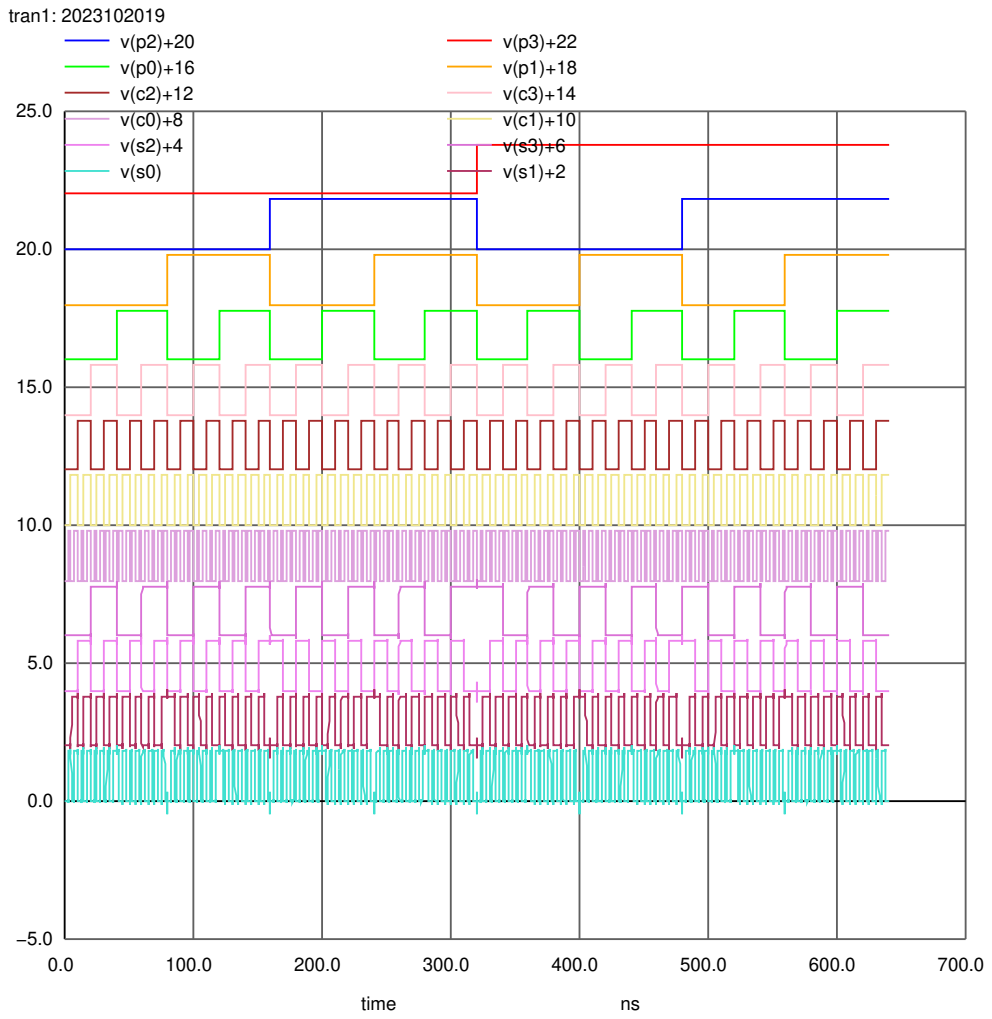
[picture p67: page 1]
time; tran1: 2023102019
