wig-nesh/4-bit-cla-adder/report/images/sum_gen_optimized_tran-eps-converted-to.pdf

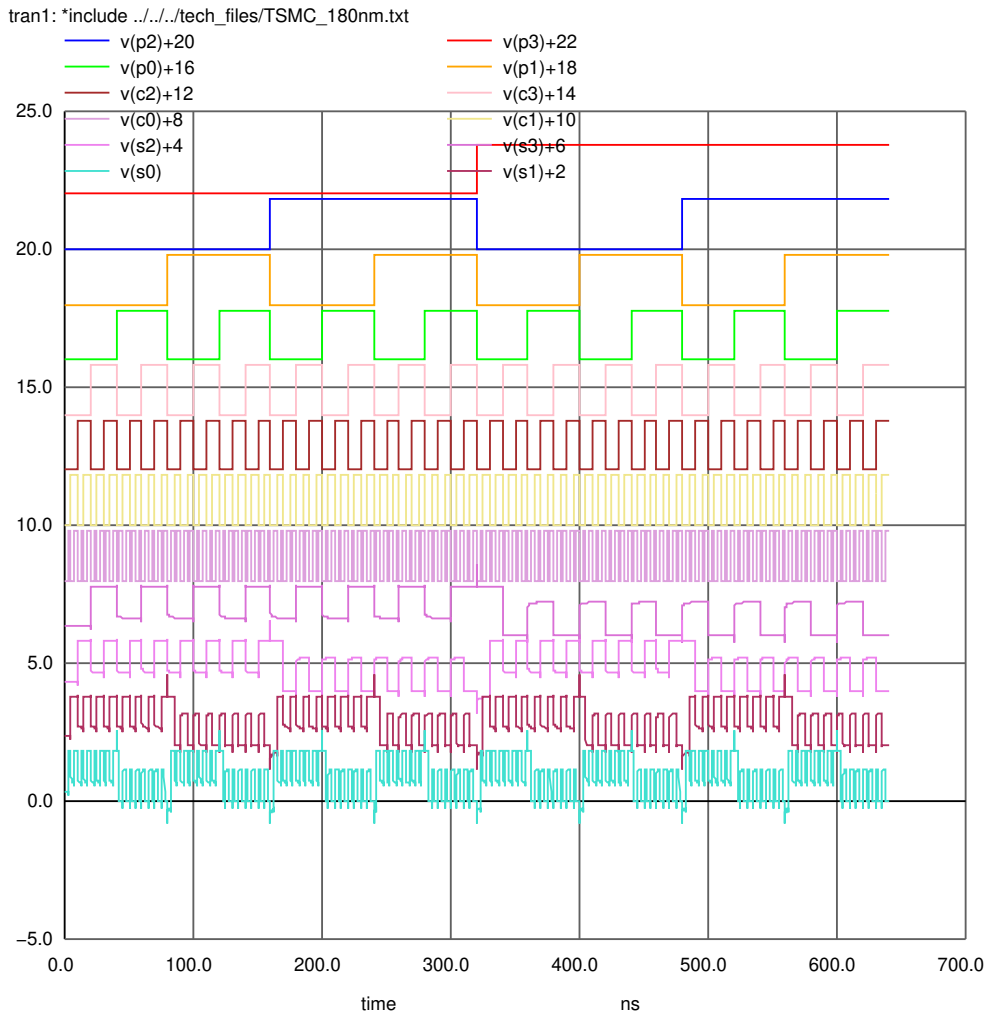
[picture p68: page 1]
time; tran1: *include ../../../tech_files/TSMC_180nm.txt
