wig-nesh/4-bit-cla-adder/pre_post_layout_simulation/ckt_blocks/full_cla/optimized/post_layout/full_cla_optimized.spice

* SPICE3 file created from full_cla_optimized.ext - technology: scmos

.option scale=0.09u

.global Vdd Gnd 

.subckt inv_cmos IN w_0_0# gnd vdd OUT
M1000 OUT IN vdd w_0_0# pfet w=50 l=2
+  ad=250 pd=110 as=250 ps=110
M1001 OUT IN gnd Gnd nfet w=20 l=2
+  ad=100 pd=50 as=100 ps=50
C0 w_0_0# vdd 0.07fF
C1 OUT gnd 0.21fF
C2 vdd OUT 0.52fF
C3 IN gnd 0.05fF
C4 IN vdd 0.02fF
C5 w_0_0# OUT 0.07fF
C6 w_0_0# IN 0.06fF
C7 IN OUT 0.05fF
C8 gnd Gnd 0.06fF
C9 OUT Gnd 0.05fF
C10 vdd Gnd 0.00fF
C11 IN Gnd 0.13fF
C12 w_0_0# Gnd 1.49fF
.ends

.subckt nor_3_cmos a_23_0# w_n6_n6# Y a_7_0# gnd A vdd B C
M1000 a_7_0# A vdd w_n6_n6# pfet w=150 l=2
+  ad=1500 pd=620 as=750 ps=310
M1001 Y C a_23_0# w_n6_n6# pfet w=150 l=2
+  ad=750 pd=310 as=1500 ps=620
M1002 a_23_0# B a_7_0# w_n6_n6# pfet w=150 l=2
+  ad=0 pd=0 as=0 ps=0
M1003 Y A gnd Gnd nfet w=20 l=2
+  ad=300 pd=150 as=300 ps=150
M1004 Y B gnd Gnd nfet w=20 l=2
+  ad=0 pd=0 as=0 ps=0
M1005 Y C gnd Gnd nfet w=20 l=2
+  ad=0 pd=0 as=0 ps=0
C0 Y gnd 1.21fF
C1 w_n6_n6# B 0.06fF
C2 vdd a_7_0# 1.55fF
C3 w_n6_n6# Y 0.17fF
C4 a_7_0# a_23_0# 1.55fF
C5 B a_7_0# 0.02fF
C6 C a_23_0# 0.02fF
C7 w_n6_n6# a_7_0# 0.32fF
C8 C Y 0.24fF
C9 w_n6_n6# C 0.06fF
C10 A Y 0.05fF
C11 A gnd 0.05fF
C12 w_n6_n6# A 0.06fF
C13 a_23_0# Y 1.55fF
C14 w_n6_n6# vdd 0.17fF
C15 B Y 0.19fF
C16 w_n6_n6# a_23_0# 0.32fF
C17 gnd Gnd 0.23fF
C18 Y Gnd 0.22fF
C19 a_23_0# Gnd 0.00fF
C20 a_7_0# Gnd 0.00fF
C21 vdd Gnd 0.01fF
C22 C Gnd 0.17fF
C23 B Gnd 0.17fF
C24 A Gnd 0.17fF
C25 w_n6_n6# Gnd 9.11fF
.ends

.subckt nand_3_cmos w_n6_n6# a_7_n81# Y gnd A vdd B C a_23_n81#
M1000 Y A vdd w_n6_n6# pfet w=50 l=2
+  ad=750 pd=330 as=750 ps=330
M1001 Y C vdd w_n6_n6# pfet w=50 l=2
+  ad=0 pd=0 as=0 ps=0
M1002 Y B vdd w_n6_n6# pfet w=50 l=2
+  ad=0 pd=0 as=0 ps=0
M1003 a_7_n81# A gnd Gnd nfet w=60 l=2
+  ad=600 pd=260 as=300 ps=130
M1004 a_23_n81# B a_7_n81# Gnd nfet w=60 l=2
+  ad=600 pd=260 as=0 ps=0
M1005 Y C a_23_n81# Gnd nfet w=60 l=2
+  ad=300 pd=130 as=0 ps=0
C0 B Y 0.19fF
C1 w_n6_n6# A 0.06fF
C2 C Y 0.24fF
C3 gnd a_7_n81# 0.62fF
C4 Y a_23_n81# 0.62fF
C5 vdd Y 2.69fF
C6 A vdd 0.02fF
C7 A Y 0.05fF
C8 a_7_n81# B 0.10fF
C9 a_7_n81# a_23_n81# 0.62fF
C10 w_n6_n6# B 0.06fF
C11 w_n6_n6# C 0.06fF
C12 w_n6_n6# vdd 0.25fF
C13 w_n6_n6# Y 0.22fF
C14 C a_23_n81# 0.10fF
C15 a_23_n81# Gnd 0.14fF
C16 a_7_n81# Gnd 0.14fF
C17 gnd Gnd 0.10fF
C18 Y Gnd 0.20fF
C19 vdd Gnd 0.08fF
C20 C Gnd 0.17fF
C21 B Gnd 0.17fF
C22 A Gnd 0.17fF
C23 w_n6_n6# Gnd 3.49fF
.ends

.subckt nor_4_cmos a_23_0# w_n6_n6# Y a_7_0# gnd A vdd B C D a_39_0#
M1000 Y D gnd Gnd nfet w=20 l=2
+  ad=400 pd=200 as=400 ps=200
M1001 a_7_0# A vdd w_n6_n6# pfet w=200 l=2
+  ad=2000 pd=820 as=1000 ps=410
M1002 a_39_0# C a_23_0# w_n6_n6# pfet w=200 l=2
+  ad=2000 pd=820 as=2000 ps=820
M1003 a_23_0# B a_7_0# w_n6_n6# pfet w=200 l=2
+  ad=0 pd=0 as=0 ps=0
M1004 Y A gnd Gnd nfet w=20 l=2
+  ad=0 pd=0 as=0 ps=0
M1005 Y B gnd Gnd nfet w=20 l=2
+  ad=0 pd=0 as=0 ps=0
M1006 Y C gnd Gnd nfet w=20 l=2
+  ad=0 pd=0 as=0 ps=0
M1007 Y D a_39_0# w_n6_n6# pfet w=200 l=2
+  ad=1000 pd=410 as=0 ps=0
C0 Y D 0.24fF
C1 w_n6_n6# D 0.06fF
C2 Y w_n6_n6# 0.22fF
C3 Y A 0.05fF
C4 w_n6_n6# A 0.06fF
C5 Y gnd 1.71fF
C6 vdd a_7_0# 2.06fF
C7 a_39_0# a_23_0# 2.06fF
C8 gnd A 0.05fF
C9 B Y 0.19fF
C10 B w_n6_n6# 0.06fF
C11 vdd w_n6_n6# 0.22fF
C12 C Y 0.19fF
C13 a_23_0# a_7_0# 2.06fF
C14 C w_n6_n6# 0.06fF
C15 a_39_0# Y 2.06fF
C16 a_39_0# w_n6_n6# 0.42fF
C17 a_23_0# w_n6_n6# 0.42fF
C18 a_7_0# w_n6_n6# 0.42fF
C19 gnd Gnd 0.32fF
C20 Y Gnd 0.30fF
C21 a_39_0# Gnd 0.00fF
C22 a_23_0# Gnd 0.00fF
C23 a_7_0# Gnd 0.00fF
C24 vdd Gnd 0.01fF
C25 D Gnd 0.17fF
C26 C Gnd 0.17fF
C27 B Gnd 0.17fF
C28 A Gnd 0.17fF
C29 w_n6_n6# Gnd 15.33fF
.ends

.subckt nand_cmos w_n6_n6# a_7_n61# Y gnd A vdd B
M1000 a_7_n61# A gnd Gnd nfet w=40 l=2
+  ad=400 pd=180 as=200 ps=90
M1001 Y B a_7_n61# Gnd nfet w=40 l=2
+  ad=200 pd=90 as=0 ps=0
M1002 Y A vdd w_n6_n6# pfet w=50 l=2
+  ad=500 pd=220 as=500 ps=220
M1003 Y B vdd w_n6_n6# pfet w=50 l=2
+  ad=0 pd=0 as=0 ps=0
C0 a_7_n61# gnd 0.41fF
C1 B Y 0.24fF
C2 Y A 0.05fF
C3 w_n6_n6# B 0.06fF
C4 vdd Y 1.60fF
C5 w_n6_n6# A 0.06fF
C6 a_7_n61# B 0.05fF
C7 w_n6_n6# vdd 0.16fF
C8 w_n6_n6# Y 0.15fF
C9 vdd A 0.02fF
C10 a_7_n61# Y 0.41fF
C11 a_7_n61# Gnd 0.10fF
C12 gnd Gnd 0.07fF
C13 Y Gnd 0.14fF
C14 vdd Gnd 0.05fF
C15 B Gnd 0.17fF
C16 A Gnd 0.17fF
C17 w_n6_n6# Gnd 2.55fF
.ends

.subckt nor_cmos w_n6_n6# Y a_7_0# gnd A vdd B
M1000 a_7_0# A vdd w_n6_n6# pfet w=100 l=2
+  ad=1000 pd=420 as=500 ps=210
M1001 Y B a_7_0# w_n6_n6# pfet w=100 l=2
+  ad=500 pd=210 as=0 ps=0
M1002 Y A gnd Gnd nfet w=20 l=2
+  ad=200 pd=100 as=200 ps=100
M1003 Y B gnd Gnd nfet w=20 l=2
+  ad=0 pd=0 as=0 ps=0
C0 vdd a_7_0# 1.03fF
C1 gnd Y 0.71fF
C2 a_7_0# Y 1.03fF
C3 gnd A 0.05fF
C4 w_n6_n6# vdd 0.12fF
C5 w_n6_n6# a_7_0# 0.22fF
C6 w_n6_n6# Y 0.12fF
C7 Y A 0.05fF
C8 B a_7_0# 0.02fF
C9 w_n6_n6# A 0.06fF
C10 B Y 0.24fF
C11 B w_n6_n6# 0.06fF
C12 gnd Gnd 0.15fF
C13 Y Gnd 0.15fF
C14 a_7_0# Gnd 0.00fF
C15 vdd Gnd 0.01fF
C16 B Gnd 0.17fF
C17 A Gnd 0.17fF
C18 w_n6_n6# Gnd 4.50fF
.ends

.subckt nand_4_cmos w_n6_n6# a_7_n101# Y a_7_0# gnd A vdd a_39_n101# B a_23_n101#
+ C D
M1000 Y D a_39_n101# Gnd nfet w=80 l=2
+  ad=400 pd=170 as=800 ps=340
M1001 Y A vdd w_n6_n6# pfet w=50 l=2
+  ad=1000 pd=440 as=1000 ps=440
M1002 Y C vdd w_n6_n6# pfet w=50 l=2
+  ad=0 pd=0 as=0 ps=0
M1003 Y B vdd w_n6_n6# pfet w=50 l=2
+  ad=0 pd=0 as=0 ps=0
M1004 a_7_n101# A gnd Gnd nfet w=80 l=2
+  ad=800 pd=340 as=400 ps=170
M1005 a_39_n101# C a_23_n101# Gnd nfet w=80 l=2
+  ad=0 pd=0 as=800 ps=340
M1006 a_23_n101# B a_7_n101# Gnd nfet w=80 l=2
+  ad=0 pd=0 as=0 ps=0
M1007 Y D vdd w_n6_n6# pfet w=50 l=2
+  ad=0 pd=0 as=0 ps=0
C0 a_23_n101# a_39_n101# 0.82fF
C1 Y C 0.19fF
C2 w_n6_n6# C 0.06fF
C3 D a_39_n101# 0.10fF
C4 Y w_n6_n6# 0.29fF
C5 B a_7_n101# 0.10fF
C6 Y A 0.05fF
C7 w_n6_n6# A 0.06fF
C8 gnd a_7_n101# 0.82fF
C9 Y vdd 3.78fF
C10 w_n6_n6# vdd 0.34fF
C11 C a_23_n101# 0.10fF
C12 A vdd 0.02fF
C13 D Y 0.24fF
C14 Y a_39_n101# 0.82fF
C15 D w_n6_n6# 0.06fF
C16 a_7_n101# a_23_n101# 0.82fF
C17 Y B 0.19fF
C18 B w_n6_n6# 0.06fF
C19 a_39_n101# Gnd 0.18fF
C20 a_23_n101# Gnd 0.18fF
C21 a_7_n101# Gnd 0.18fF
C22 gnd Gnd 0.12fF
C23 Y Gnd 0.15fF
C24 vdd Gnd 0.11fF
C25 D Gnd 0.15fF
C26 C Gnd 0.15fF
C27 B Gnd 0.15fF
C28 A Gnd -0.00fF
C29 w_n6_n6# Gnd 4.48fF
.ends

.subckt nor_5_cmos a_23_0# w_n6_n6# Y a_7_0# gnd A vdd B C D a_39_0# E a_55_0#
M1000 a_7_0# A vdd w_n6_n6# pfet w=250 l=2
+  ad=2500 pd=1020 as=1250 ps=510
M1001 a_39_0# C a_23_0# w_n6_n6# pfet w=250 l=2
+  ad=2500 pd=1020 as=2500 ps=1020
M1002 a_23_0# B a_7_0# w_n6_n6# pfet w=250 l=2
+  ad=0 pd=0 as=0 ps=0
M1003 Y D gnd Gnd nfet w=20 l=2
+  ad=500 pd=250 as=500 ps=250
M1004 Y E gnd Gnd nfet w=20 l=2
+  ad=0 pd=0 as=0 ps=0
M1005 Y A gnd Gnd nfet w=20 l=2
+  ad=0 pd=0 as=0 ps=0
M1006 Y E a_55_0# w_n6_n6# pfet w=250 l=2
+  ad=1250 pd=510 as=2500 ps=1020
M1007 Y B gnd Gnd nfet w=20 l=2
+  ad=0 pd=0 as=0 ps=0
M1008 a_55_0# D a_39_0# w_n6_n6# pfet w=250 l=2
+  ad=0 pd=0 as=0 ps=0
M1009 Y C gnd Gnd nfet w=20 l=2
+  ad=0 pd=0 as=0 ps=0
C0 w_n6_n6# a_23_0# 0.52fF
C1 a_23_0# a_39_0# 2.58fF
C2 Y a_55_0# 2.58fF
C3 A gnd 0.05fF
C4 w_n6_n6# A 0.06fF
C5 w_n6_n6# a_39_0# 0.52fF
C6 Y B 0.19fF
C7 vdd a_7_0# 2.58fF
C8 w_n6_n6# a_55_0# 0.52fF
C9 a_39_0# a_55_0# 2.58fF
C10 w_n6_n6# B 0.06fF
C11 Y C 0.19fF
C12 Y D 0.19fF
C13 a_23_0# C 0.02fF
C14 w_n6_n6# C 0.06fF
C15 Y E 0.24fF
C16 a_7_0# a_23_0# 2.58fF
C17 vdd w_n6_n6# 0.27fF
C18 w_n6_n6# D 0.06fF
C19 a_39_0# D 0.02fF
C20 a_7_0# w_n6_n6# 0.52fF
C21 w_n6_n6# E 0.06fF
C22 a_55_0# E 0.02fF
C23 a_7_0# B 0.02fF
C24 A Y 0.05fF
C25 Y gnd 2.21fF
C26 w_n6_n6# Y 0.27fF
C27 gnd Gnd 0.41fF
C28 Y Gnd 0.38fF
C29 a_55_0# Gnd -0.00fF
C30 a_39_0# Gnd -0.00fF
C31 a_23_0# Gnd -0.00fF
C32 a_7_0# Gnd -0.00fF
C33 vdd Gnd 0.01fF
C34 E Gnd 0.17fF
C35 D Gnd 0.17fF
C36 C Gnd 0.17fF
C37 B Gnd 0.17fF
C38 A Gnd 0.17fF
C39 w_n6_n6# Gnd 23.16fF
.ends

.subckt nand_5_cmos a_7_n121# w_n6_n6# a_55_n121# Y gnd a_39_n121# a_23_n121# A vdd
+ B C D E
M1000 Y A vdd w_n6_n6# pfet w=50 l=2
+  ad=1250 pd=550 as=1250 ps=550
M1001 Y C vdd w_n6_n6# pfet w=50 l=2
+  ad=0 pd=0 as=0 ps=0
M1002 Y B vdd w_n6_n6# pfet w=50 l=2
+  ad=0 pd=0 as=0 ps=0
M1003 Y E a_55_n121# Gnd nfet w=100 l=2
+  ad=500 pd=210 as=1000 ps=420
M1004 a_55_n121# D a_39_n121# Gnd nfet w=100 l=2
+  ad=0 pd=0 as=1000 ps=420
M1005 Y E vdd w_n6_n6# pfet w=50 l=2
+  ad=0 pd=0 as=0 ps=0
M1006 Y D vdd w_n6_n6# pfet w=50 l=2
+  ad=0 pd=0 as=0 ps=0
M1007 a_7_n121# A gnd Gnd nfet w=100 l=2
+  ad=1000 pd=420 as=500 ps=210
M1008 a_39_n121# C a_23_n121# Gnd nfet w=100 l=2
+  ad=0 pd=0 as=1000 ps=420
M1009 a_23_n121# B a_7_n121# Gnd nfet w=100 l=2
+  ad=0 pd=0 as=0 ps=0
C0 a_55_n121# E 0.10fF
C1 w_n6_n6# vdd 0.42fF
C2 a_7_n121# B 0.10fF
C3 D Y 0.19fF
C4 A Y 0.05fF
C5 E Y 0.24fF
C6 a_55_n121# Y 1.03fF
C7 B Y 0.19fF
C8 C Y 0.19fF
C9 a_7_n121# gnd 1.03fF
C10 A vdd 0.02fF
C11 a_39_n121# a_23_n121# 1.03fF
C12 w_n6_n6# D 0.06fF
C13 D a_39_n121# 0.10fF
C14 w_n6_n6# A 0.06fF
C15 w_n6_n6# E 0.06fF
C16 w_n6_n6# B 0.06fF
C17 Y vdd 4.87fF
C18 a_55_n121# a_39_n121# 1.03fF
C19 w_n6_n6# C 0.06fF
C20 a_7_n121# a_23_n121# 1.03fF
C21 w_n6_n6# Y 0.37fF
C22 C a_23_n121# 0.10fF
C23 a_55_n121# Gnd 0.22fF
C24 a_39_n121# Gnd 0.22fF
C25 a_23_n121# Gnd 0.22fF
C26 a_7_n121# Gnd 0.22fF
C27 gnd Gnd 0.14fF
C28 Y Gnd 0.28fF
C29 vdd Gnd 0.14fF
C30 E Gnd 0.13fF
C31 D Gnd 0.13fF
C32 C Gnd 0.13fF
C33 B Gnd 0.13fF
C34 A Gnd 0.13fF
C35 w_n6_n6# Gnd 5.48fF
.ends
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
