wig-nesh/4-bit-cla-adder/(commit log)

2024-11-09 [+] all cmos circuit blocks ready
2024-11-09 [+] full cmos circuit done
2024-12-02 added circuit diagrams and stick diagram
